mohammadfatemieh/BTS/1-commercial_airport_interactive_light-agi.jpg

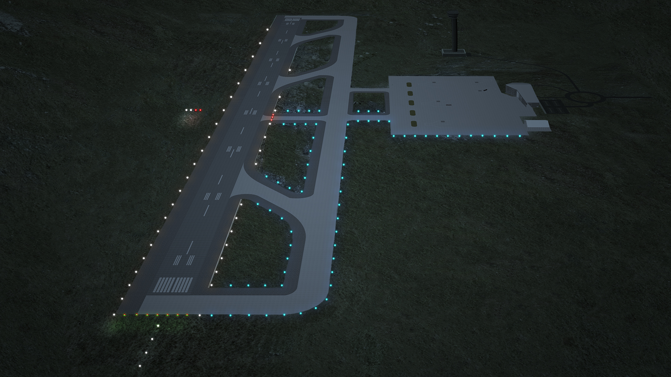
1-commercial_airport_interactive_light-agi.jpg
