mohammadfatemieh/BTS/Hardware/BTS HW v4/Air_Unit/Air_Unit_240316.PcbDoc.htm

Reporting Options

# File in Previous Format

Date | : | 4/20/2017
Time | : | 11:17:37 AM
Filename | : | C:\Users\ngoqu\Google Drive\In working\I Store medicin\Hardware\BTS HW v4\Air_Unit\Air_Unit_240316.PcbDoc

Version | Warning

This file was generated by an earlier version of the software
