mohammadfatemieh/BTS/Visio-Tongquanhethong.pdf

# 14 OMC

# External Sensor

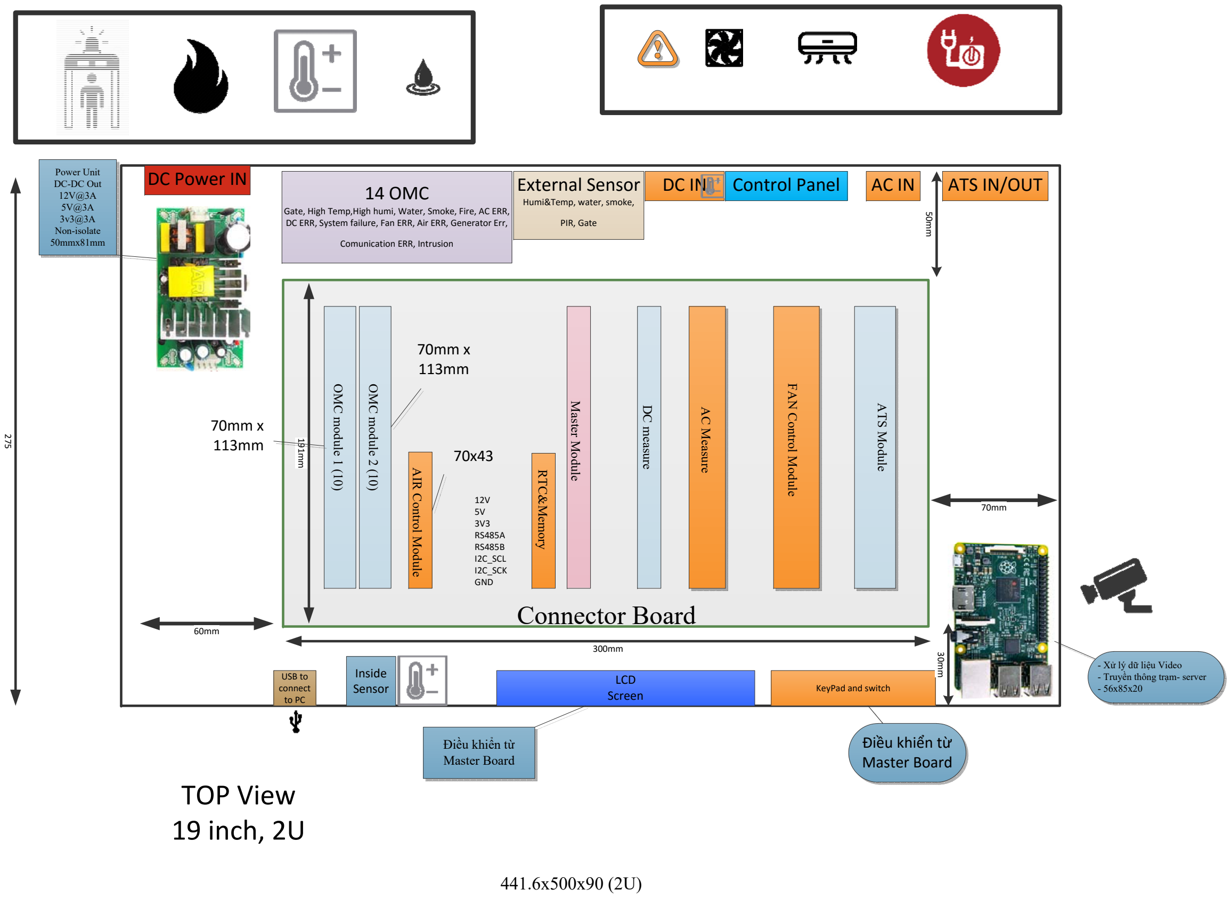
[picture p4: page 1]

## LCD

Screen | KeyPad and switch

USB to
connect
to PC

## Inside Sensor

## OMC module 1 (10) Master Module DC measure AC Measure

## ATS Module

## FAN Control Module

## AIR Control Module

Gate, High Temp,High humi, Water, Smoke, Fire, AC ERR, DC ERR, System failure, Fan ERR, Air ERR, Generator Err,

Comunication ERR, Intrusion

Humi&Temp, water, smoke,

PIR, Gate

# DC Power IN

## RTC&Memory

DC IN | Control Panel | AC IN | ATS IN/OUT

# TOP View 19 inch, 2U

# Connector Board

# 441.6x500x90 (2U)

60mm

70mm

275

300mm

191mm

30mm

50mm

12V
5V
3V3
RS485A
RS485B
I2C_SCL
I2C_SCK
GND

## OMC module 2 (10)

- Xử lý dữ liệu Video
- Truyền thông trạm- server
- 56x85x20

Power Unit
DC-DC Out
12V@3A
5V@3A
3v3@3A
Non-isolate
50mmx81mm

## Điều khiển từ Master Board

## Điều khiển từ Master Board

## 70mm x

113mm | 70x43 70mm x
| 113mm
