mohammadfatemieh/BTS/Tongquanhethong.png

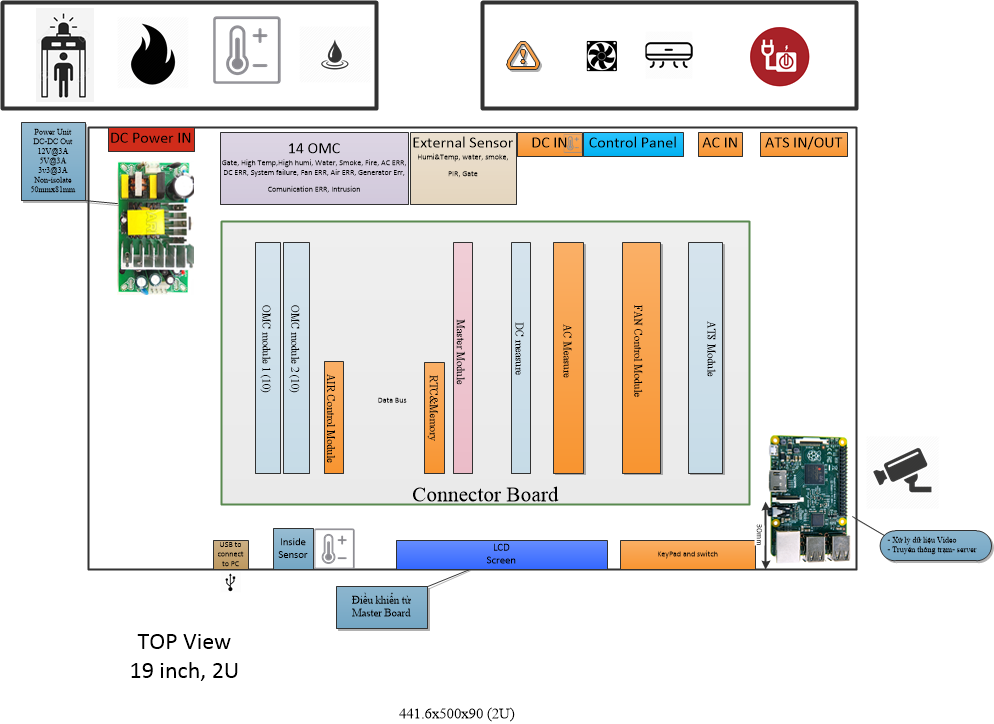
Tongquanhethong.png
