mohammadfatemieh/BTS/Hardware/IStoreMedicinv1.xlsx

Comment | Description | Designator | Footprint | Quantity | Price | Total
Thạch anh | 25MHz | 1 | cry | 2 | 2000 | 4000
Tụ điện 0603 |  |  |  | 200 | 500 | 100000
Còi hú, đèn |  |  |  | 1 | 100000 | 100000
Relay | 220V/5A |  |  | 10 | 30000 | 300000
Transistor |  |  |  | 50 | 2000 | 100000
LCD | 182x64 |  |  | 1 | 250000 | 250000
LED_RED_0805 | Typical INFRARED GaAs LED | D1 | LED 0805 TOP | 20 | 800 | 16000
Cảm biến nhiệt độ, độ ẩm | Typical INFRARED GaAs LED | D2 | LED 0805 TOP | 1 | 500000 | 500000
LED_GREEN_0805 | Typical INFRARED GaAs LED | D3 | LED 0805 TOP | 1 | 800 | 800
RJ45 | RJ45 Connector, with Leds | J1 | CONNECTOR_RJ45_HR911102A | 5 | 25000 | 125000
Điện trở 0805 | Resistor |  | RES_0805_TOP | 200 | 100 | 20000
RơLe | RALAY SOLID SSR-40DD FOTEK |  |  | 2 | 95000 | 190000
Cảm biến khói/Cháy | MQ8 |  |  | 1 | 110000 | 110000
LM35 | Cảm biến nhiệt độ |  |  | 2 | 20000 | 40000
Công tắc từ |  |  |  | 1 | 50000 | 50000
Cảm biến dòng | 20A/100mA/250KHz |  |  | 4 | 55000 | 220000
LM358 | Khuếch đại thuật toán |  |  | 10 | 7000 | 70000
BUTTON 2P | Switch | S1 | Nut nhan 2 chan dung | 5 | 4000 | 20000
STM32F107 | STM32 ARM-based 32-bit MCU with 128 Kbytes Flash, 64-pin LQFP, Industrial Temperature | U1 | LQFP64_N | 2 | 80000 | 160000
DP83848CVV | PHY IC | U2 | LQFP48 | 1 | 70000 | 70000
Nguồn AC-DC | 220V-24V-5A |  |  | 1 | 300000 | 300000
Nguồn DC-DC | 24V-12V-5V-3V3-1A |  |  | 1 | 150000 | 150000
Nguồn DC-DC | 48V-24V-5A |  |  | 1 | 250000 | 250000
Cầu chì | 5A |  |  | 3 | 10000 | 30000
Mạch in |  |  |  | 1 | 1000000 | 1000000
Quạt thông gió |  |  |  | 1 | 40000 | 40000
Dây cáp/dây điện |  |  |  | 1 | 100000 | 100000
Giắm cắm/Công tắc/Nút bấm |  |  |  | 20 | 12000 | 240000
S25FL204K | Flash Memory | U3 | SOIC_8 | 1 | 25000 | 25000
 |  |  |  |  |  | 4580800
