mohammadfatemieh/BTS/Hardware/IO_Board/IO_Boardv3_RelayAlarm.pdf

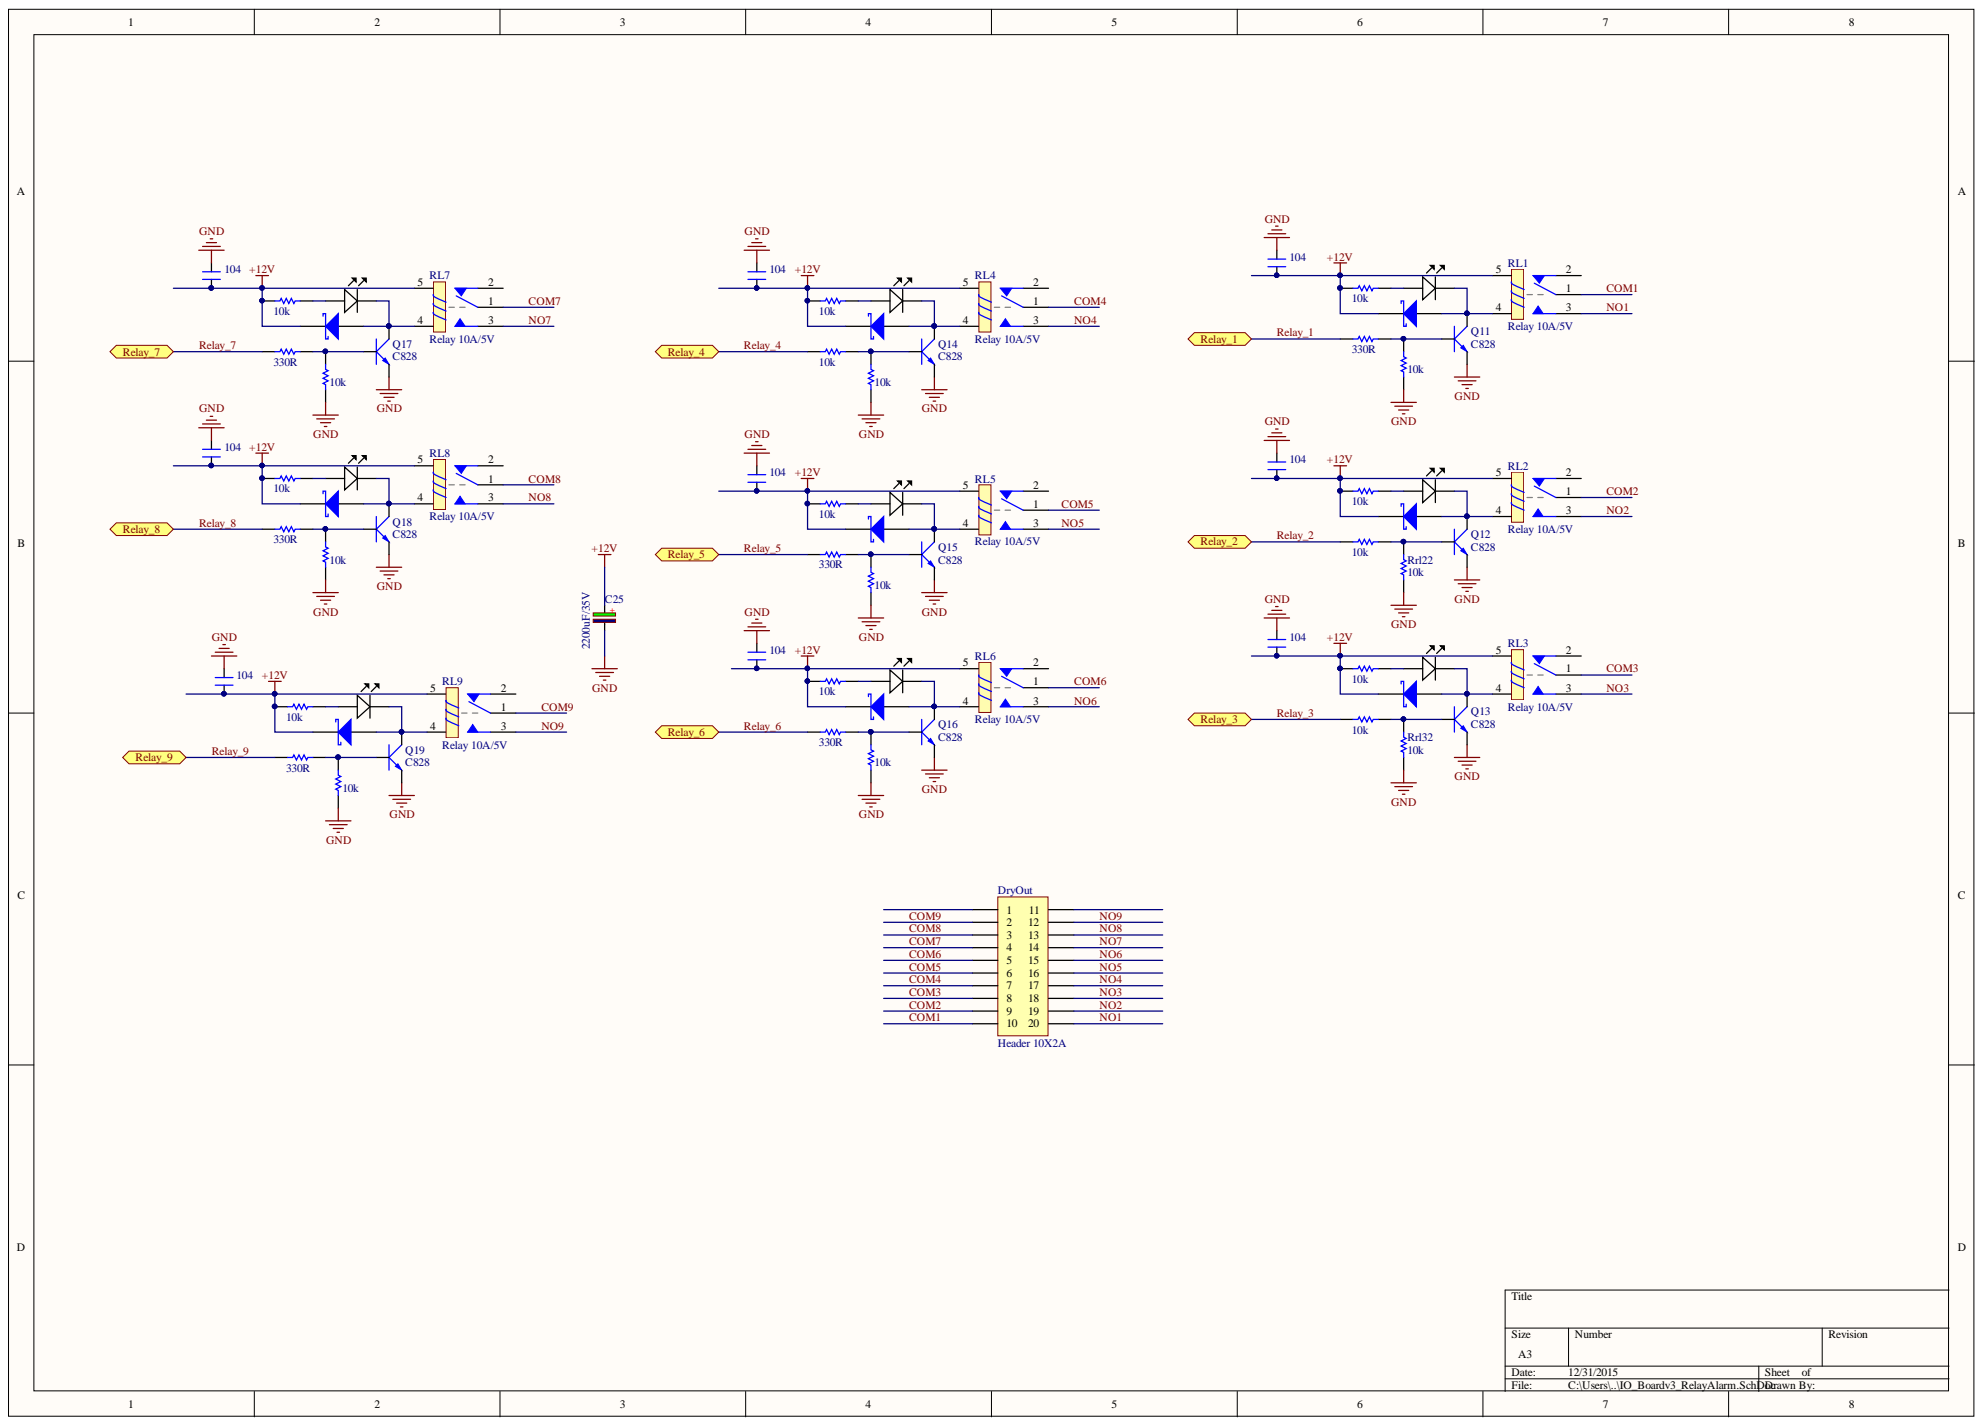
[picture p72: page 1]

# Board S
