mohammadfatemieh/BTS/Hardware/BTS HW v4/FAN Unit/FAN_Unit_250316.pdf

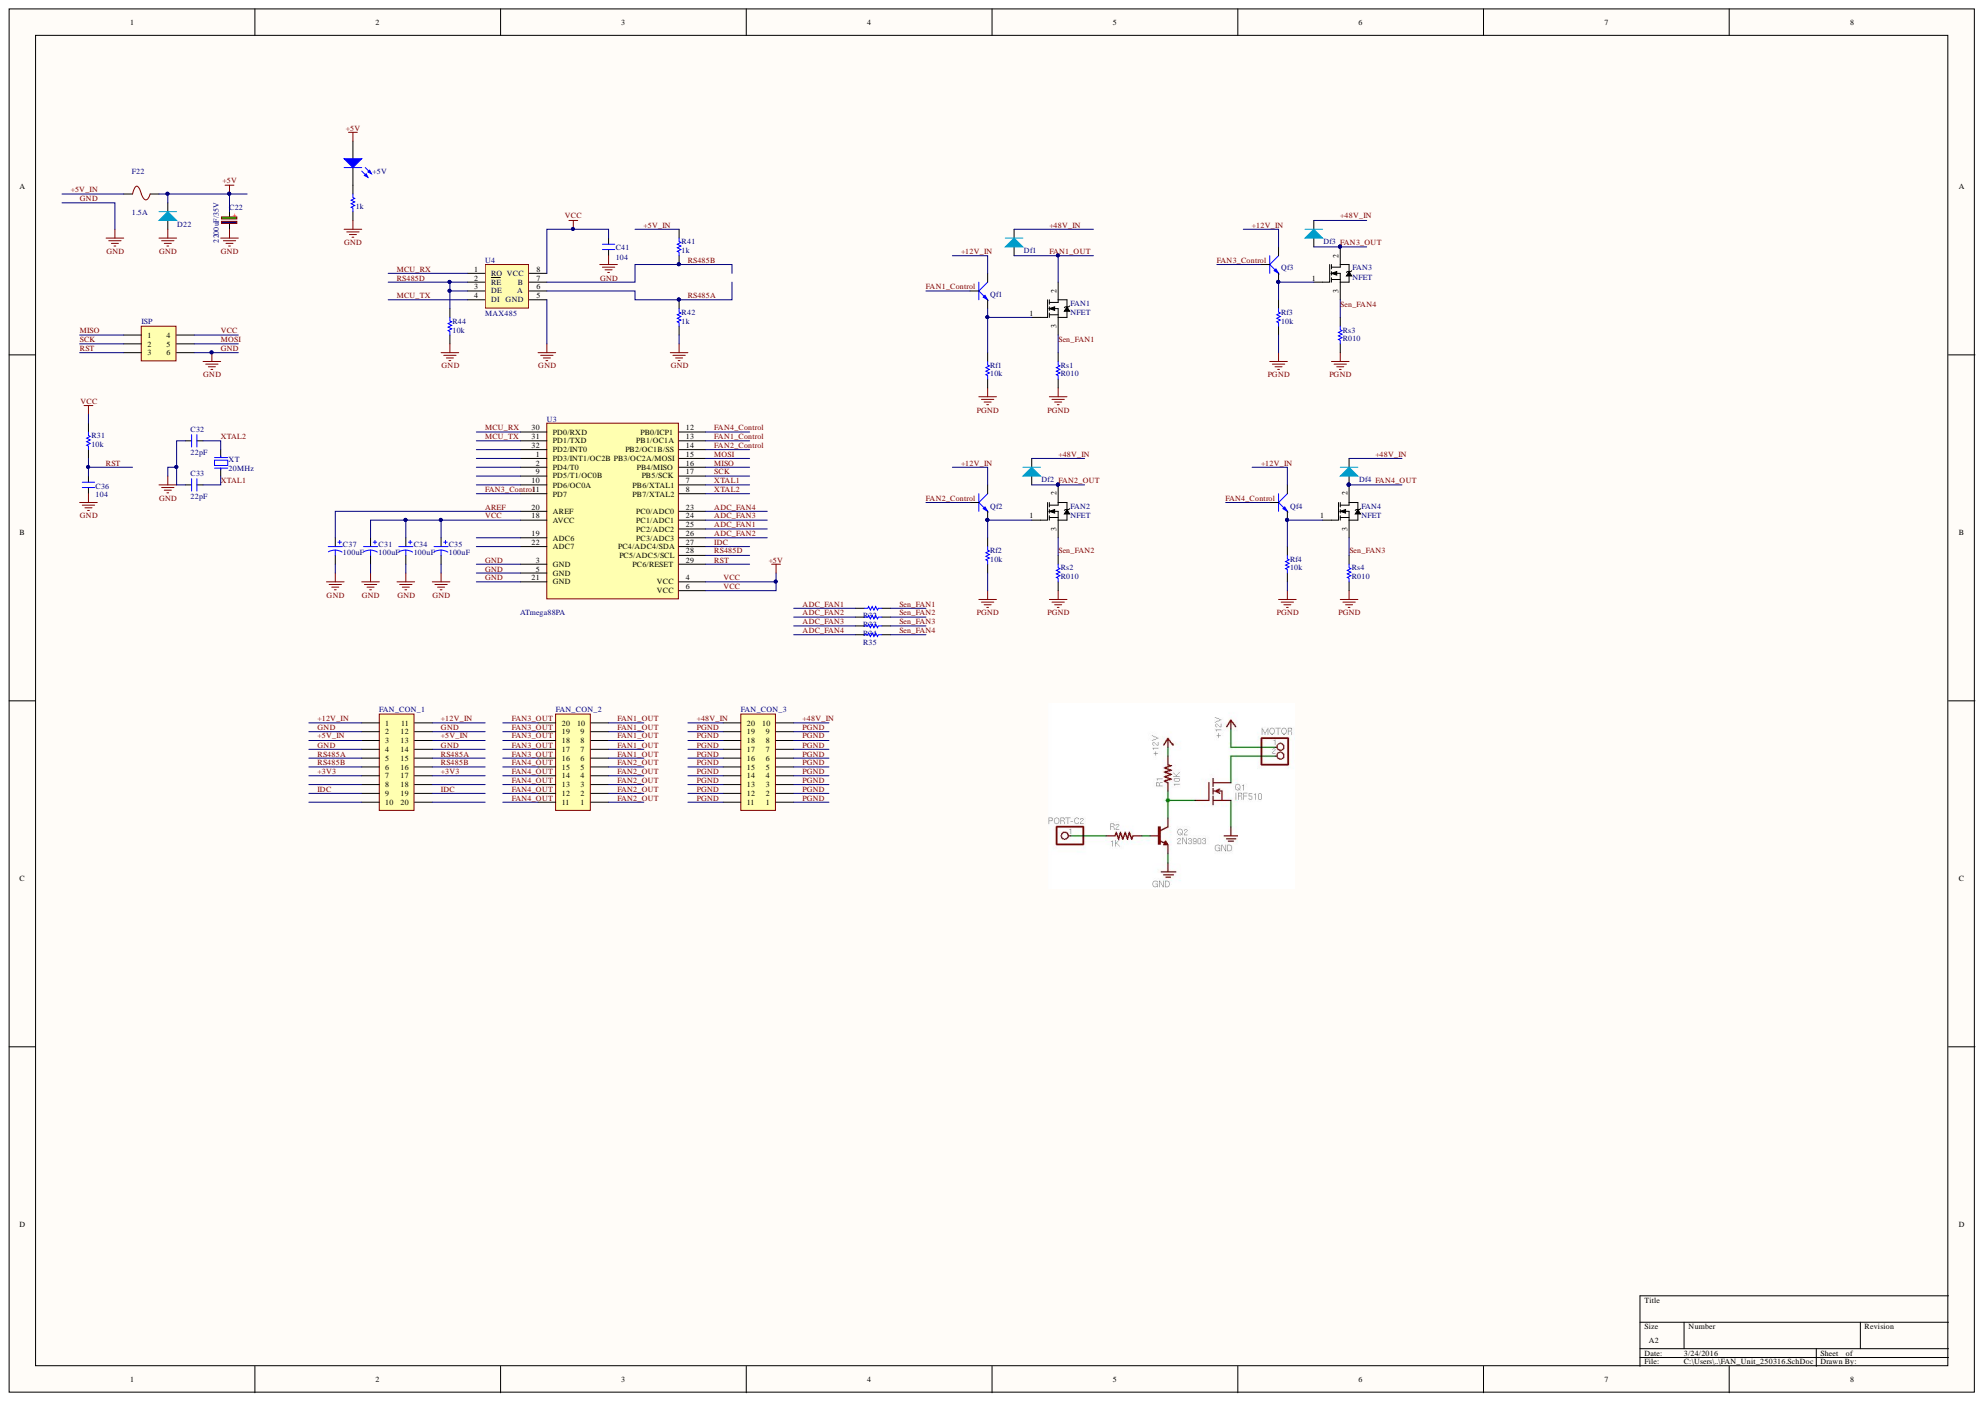
[picture p73: page 1]

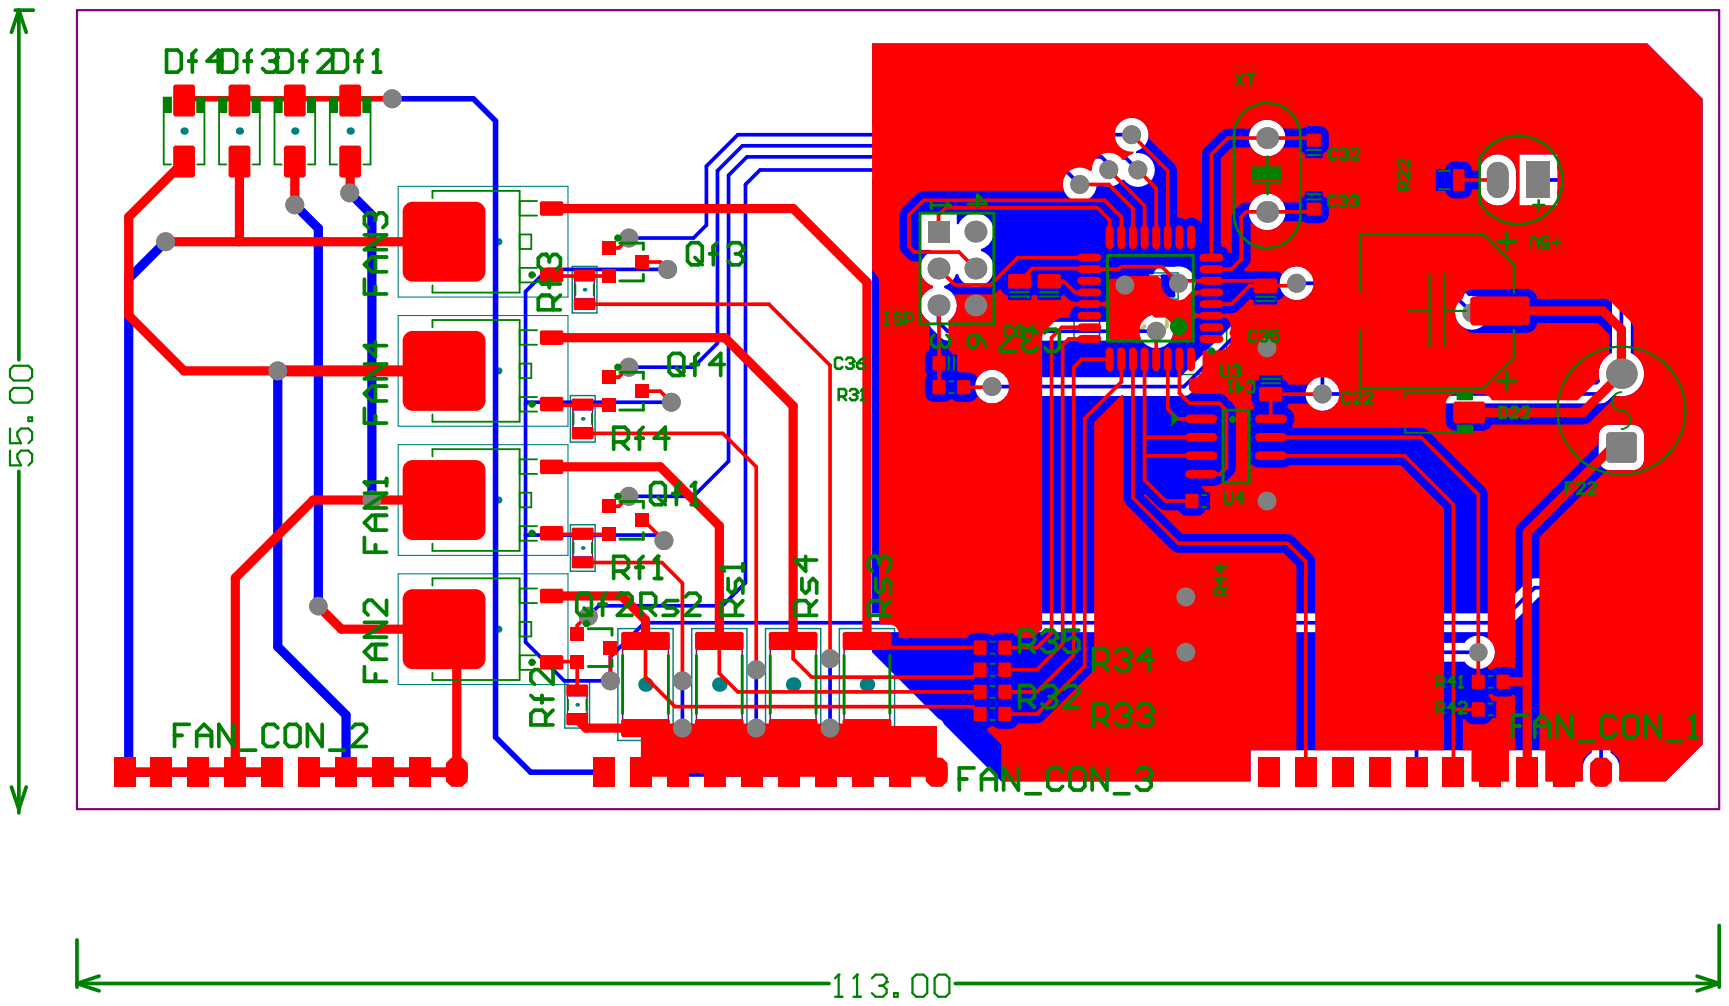
[picture p74: page 2]

# Board S
