mohammadfatemieh/BTS/Doc/amg_f4_connect_full_schematic.pdf

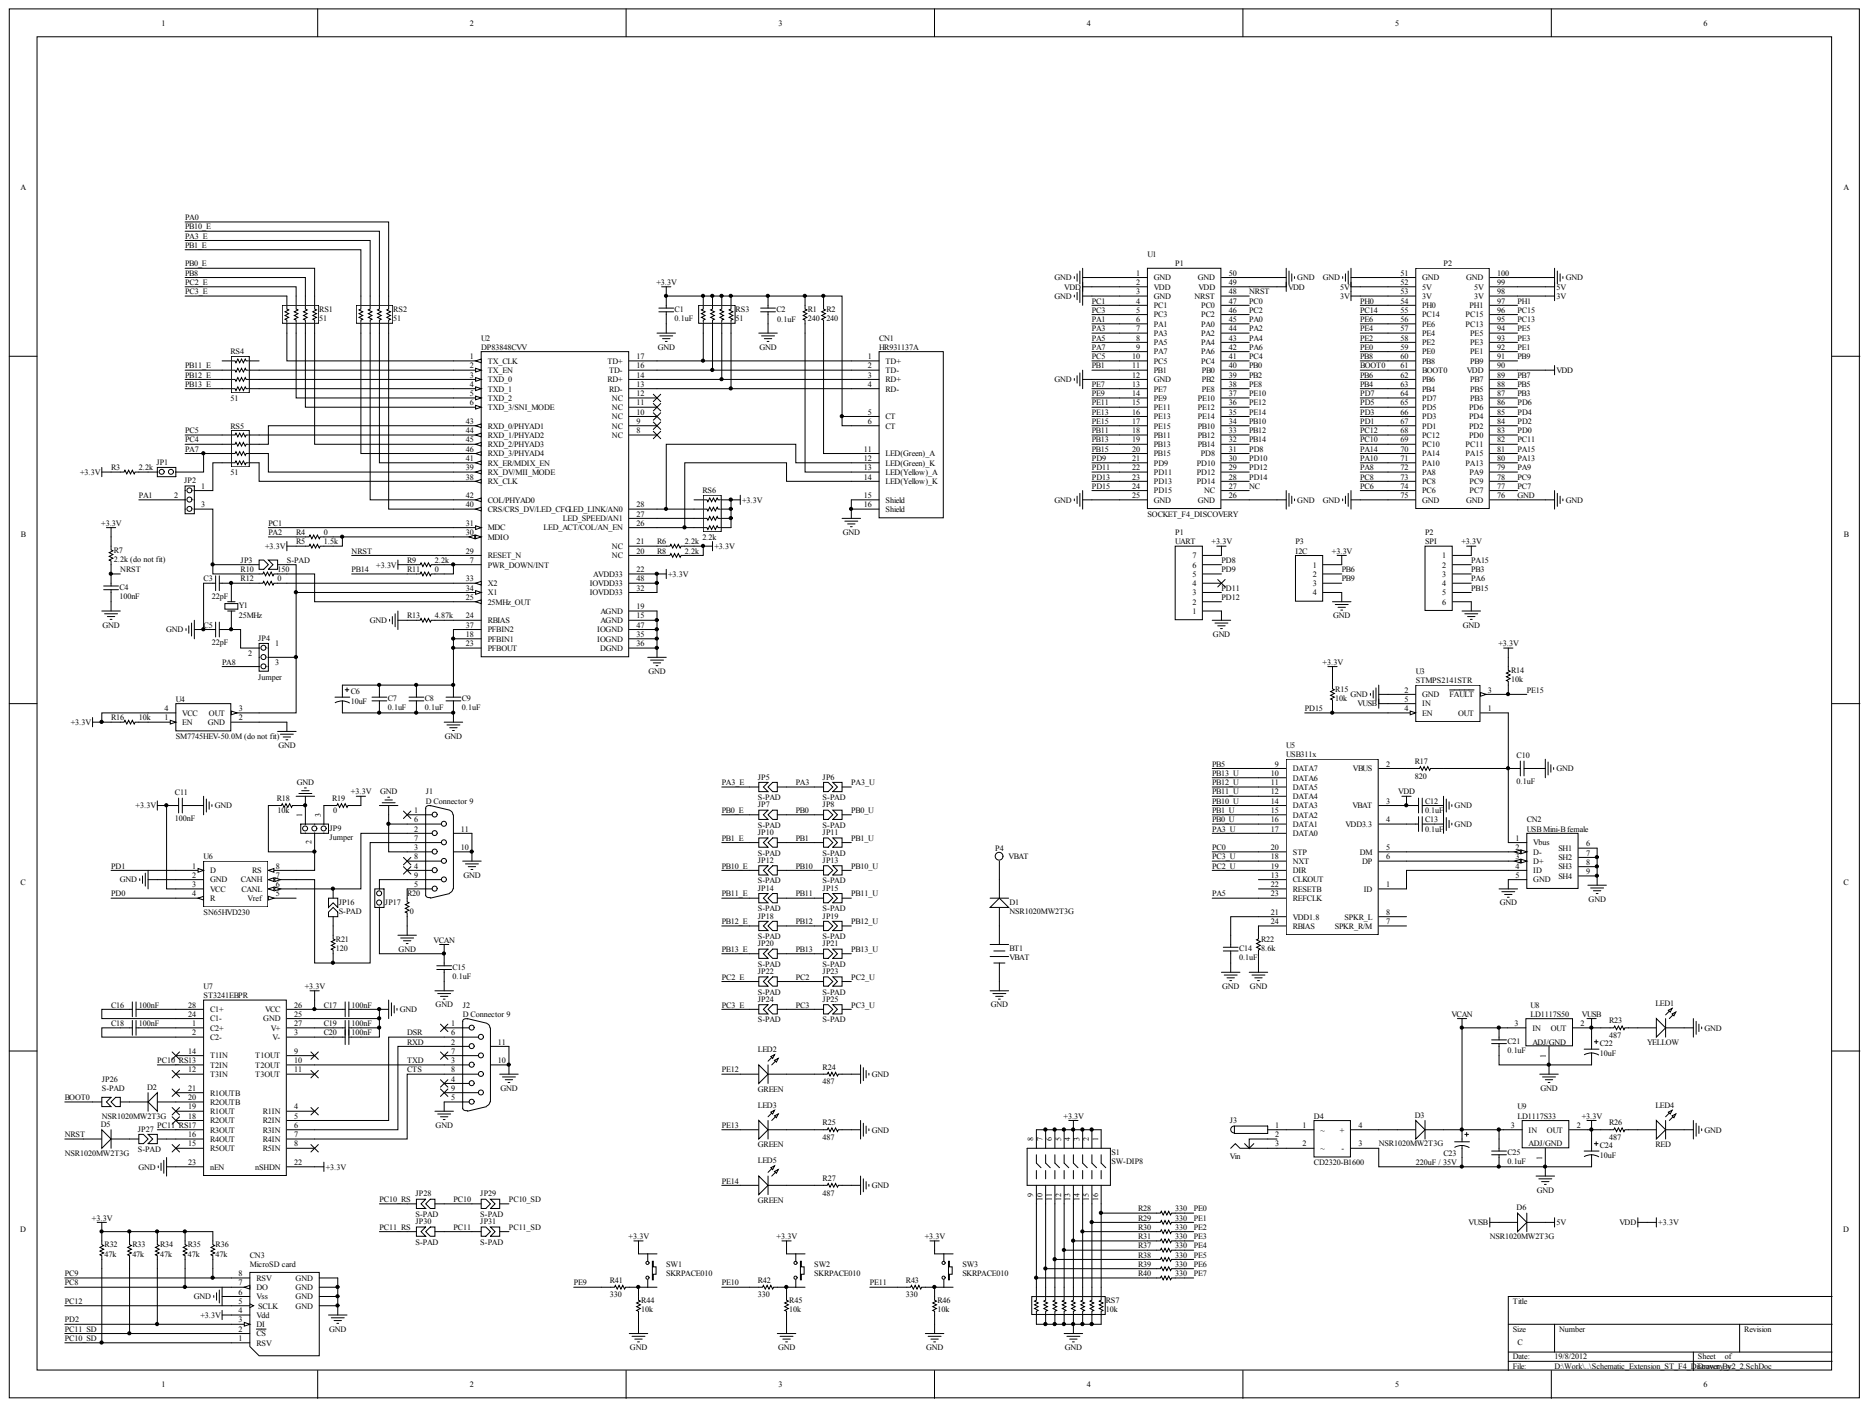
[picture p77: page 1]

RBIAS 24

PFBIN1 18
