mohammadfatemieh/BTS/Hardware/BTS HW v4/AIR_PCB.pdf

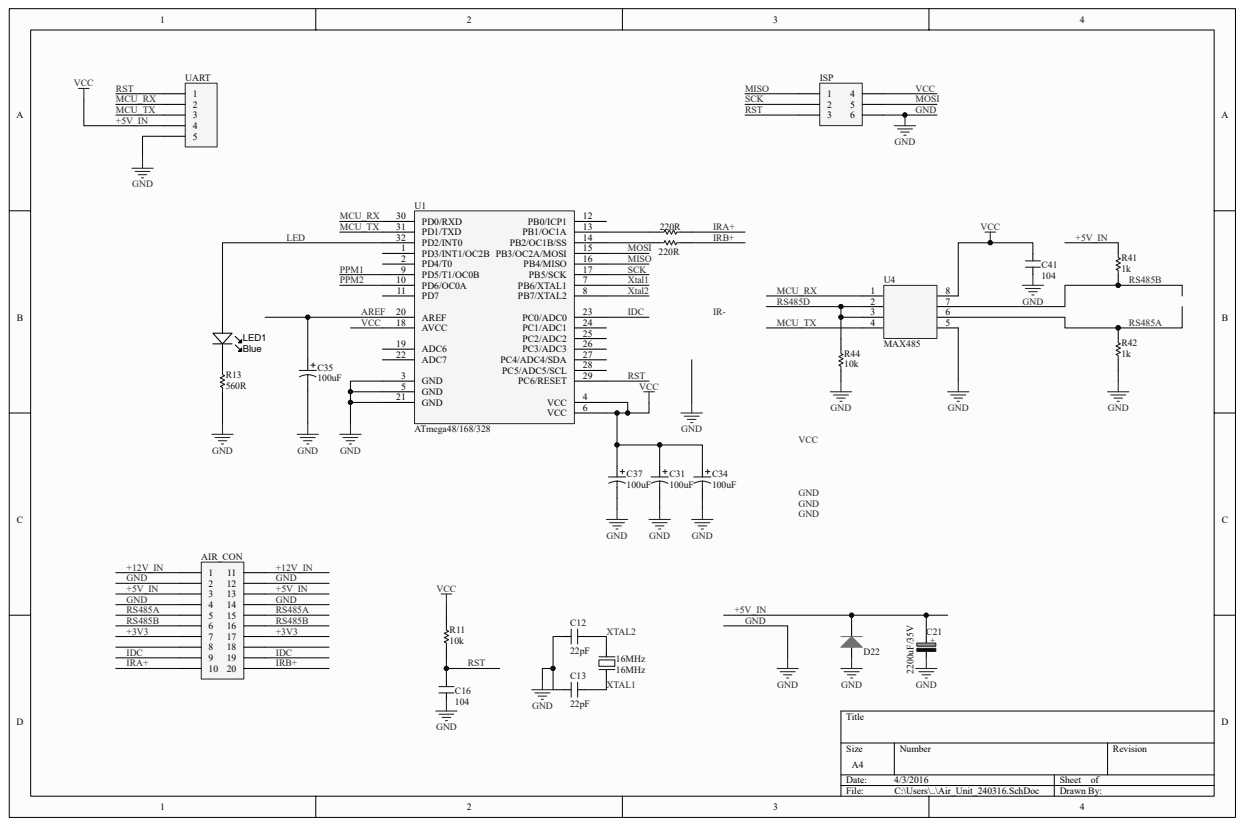
[picture p78: page 1]

Size A4 | Number | Revision

Date: 4/3/2016 | Sheet of
File: C:\Users\..\Air_Unit_240316.SchDoc | Drawn By:
