mohammadfatemieh/BTS/Hardware/BTS HW v4/AIR_SCH.pdf

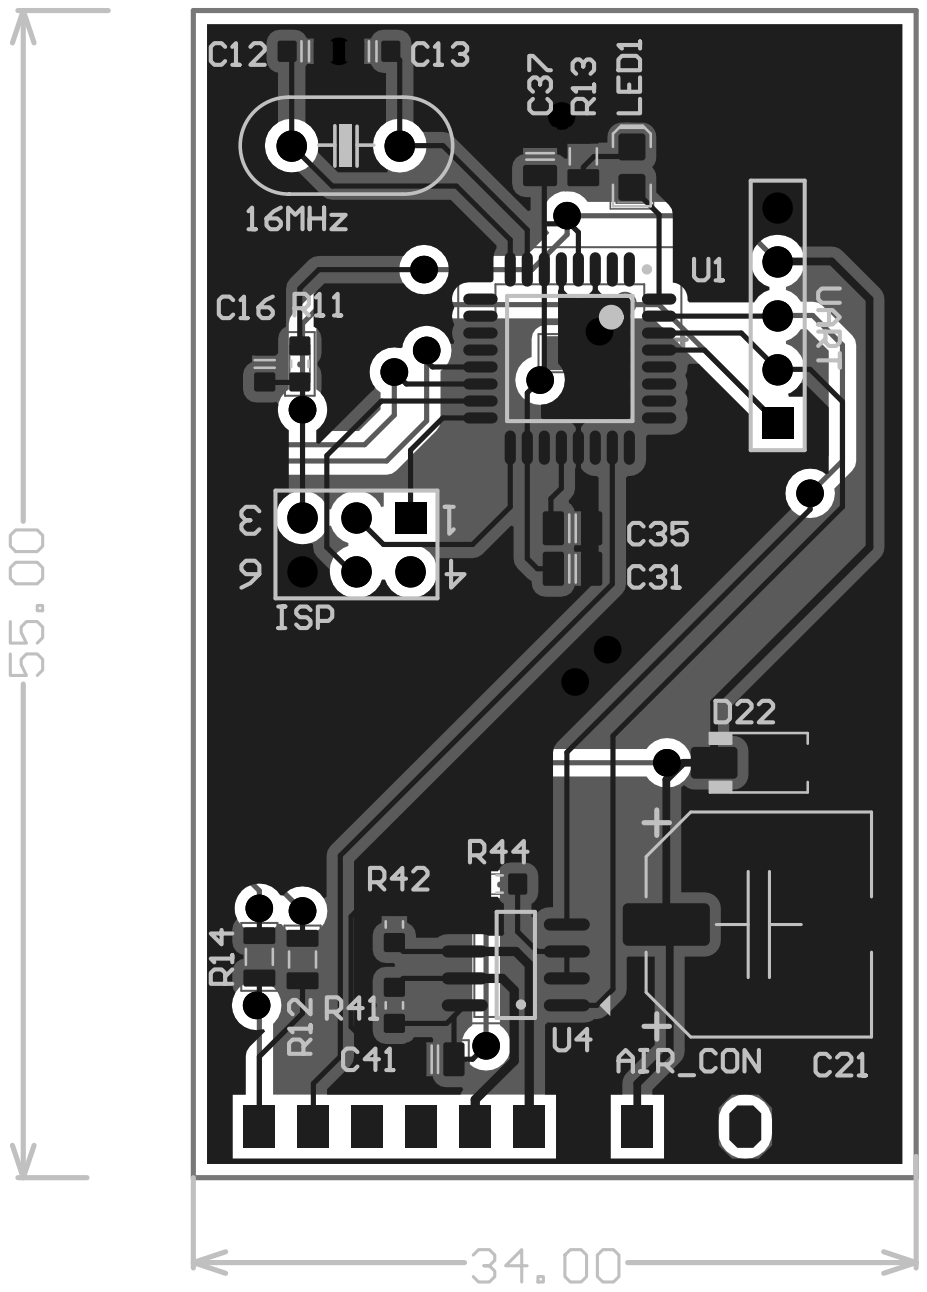
[picture p79: page 1]
