mohammadfatemieh/BTS/Hardware/BTS HW v4/ATS_PCB.pdf

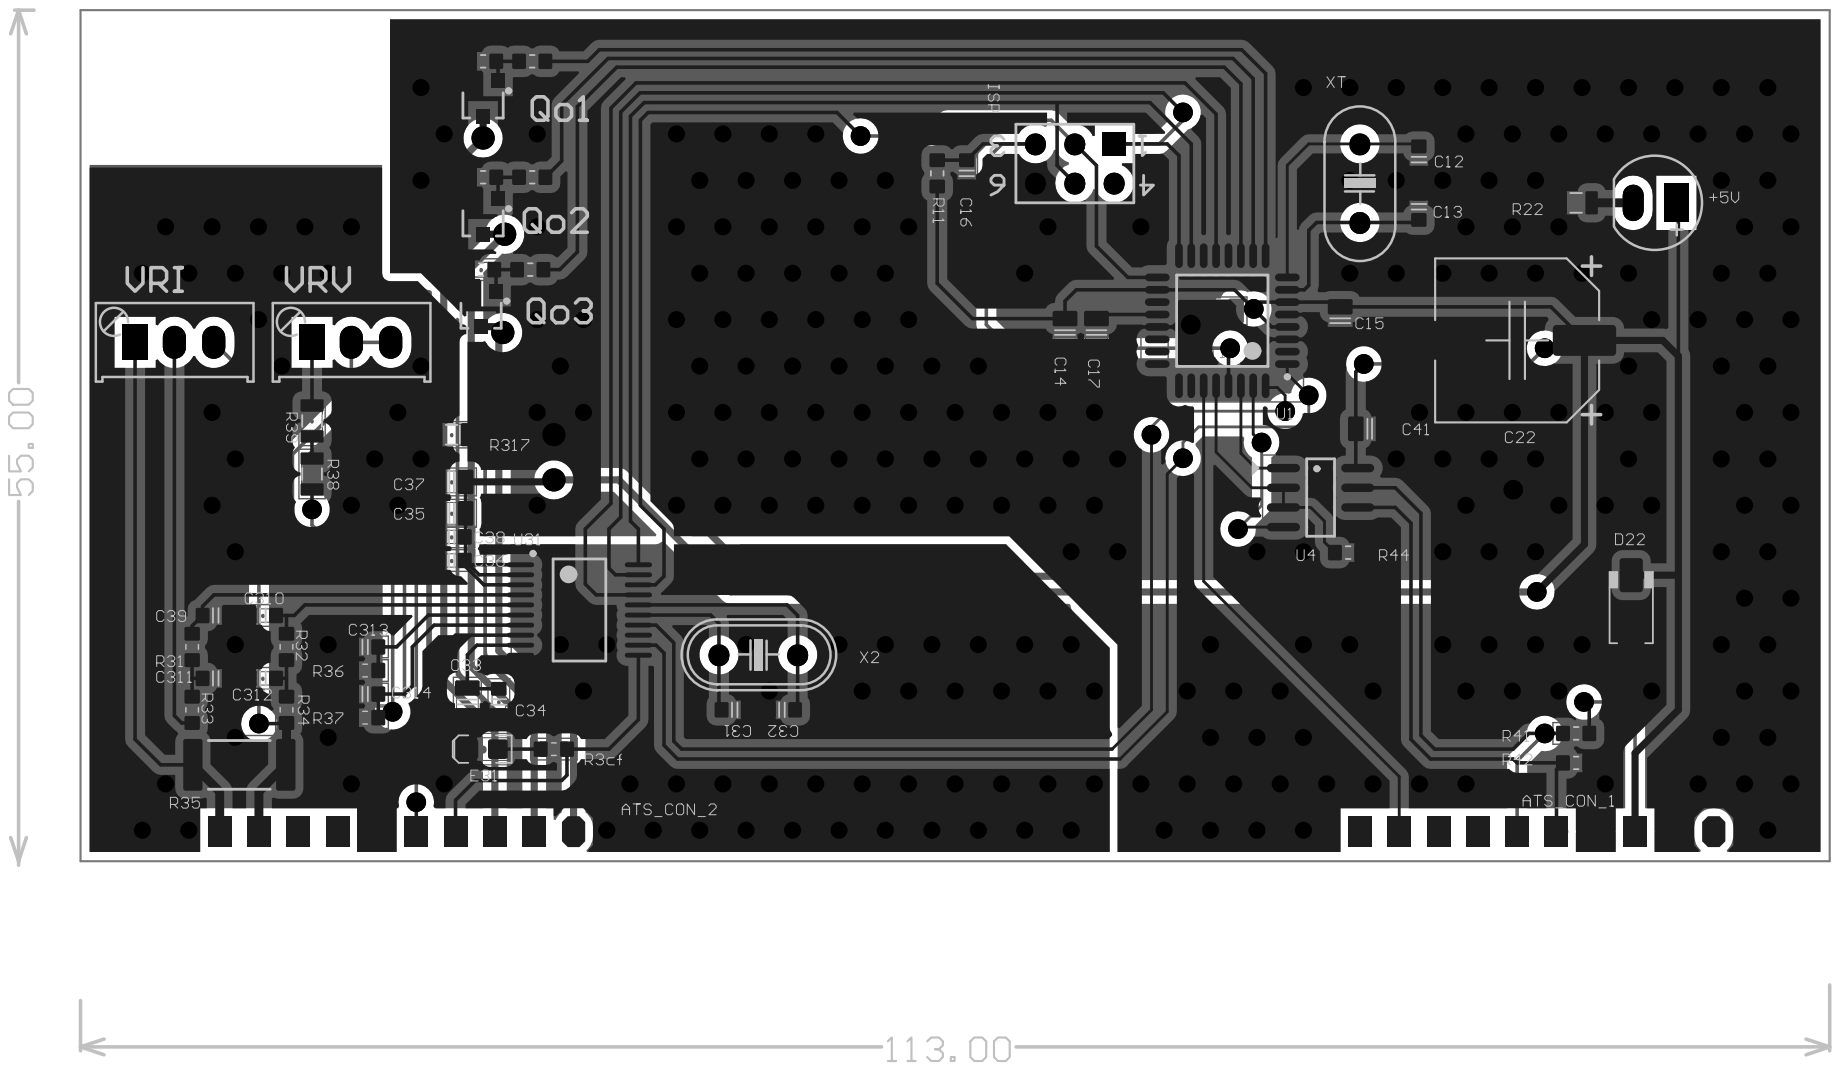
[picture p80: page 1]
