mohammadfatemieh/BTS/Hardware/BTS HW v4/ATS_Sch.pdf

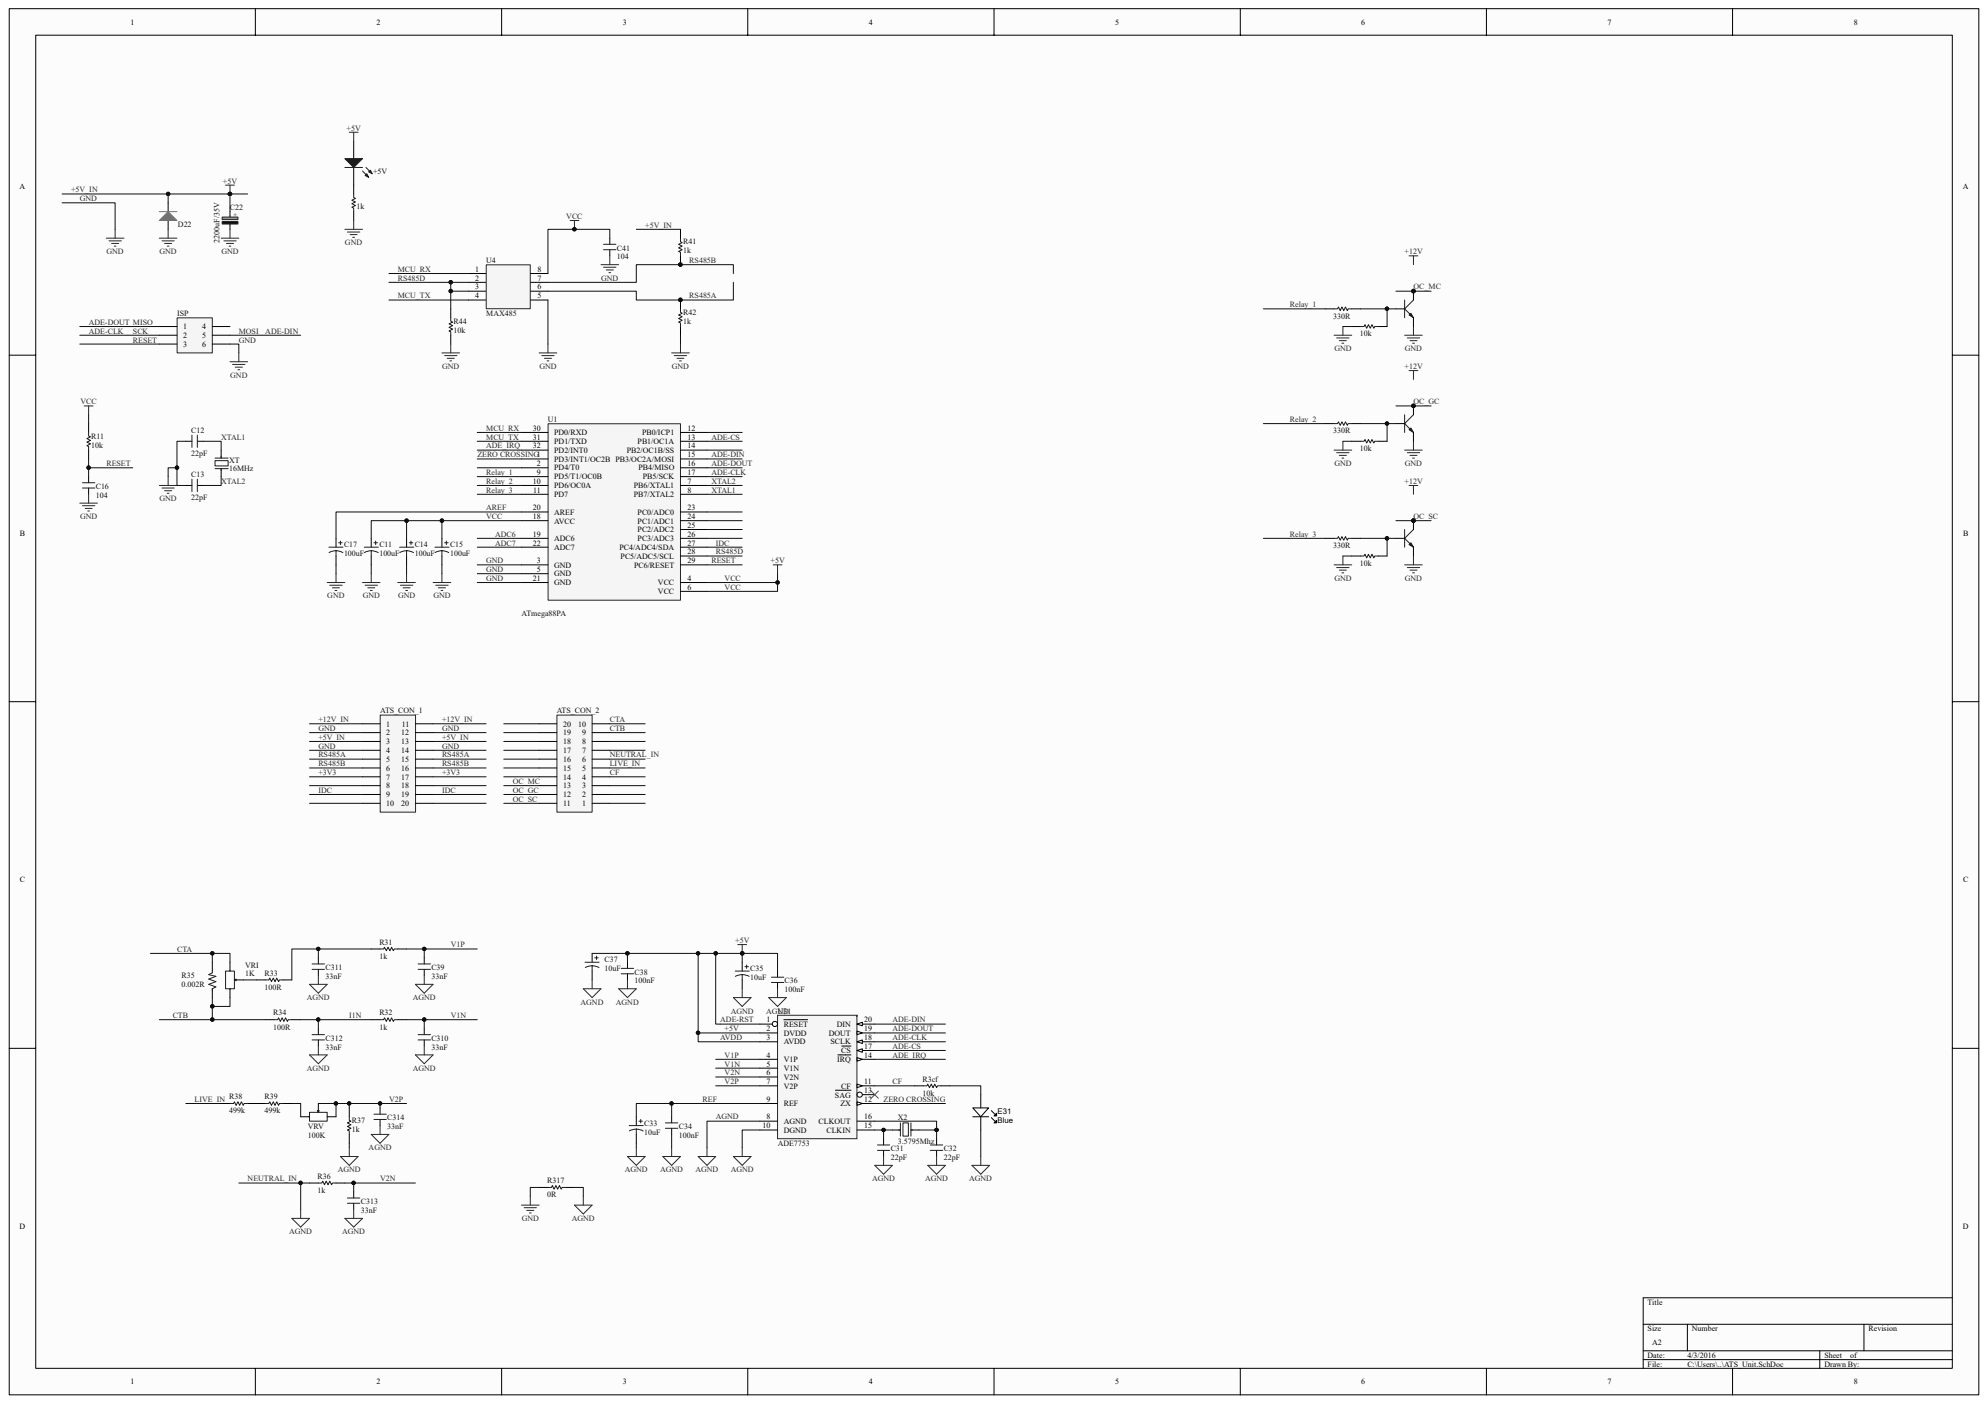
[picture p81: page 1]

Size A2 | Number | Revision

Date: 4/3/2016 | Sheet of
File: C:\Users\..\ATS_Unit.SchDoc | Drawn By:
