mohammadfatemieh/BTS/Hardware/BTS HW v4/DC_Mea_Pcb.pdf

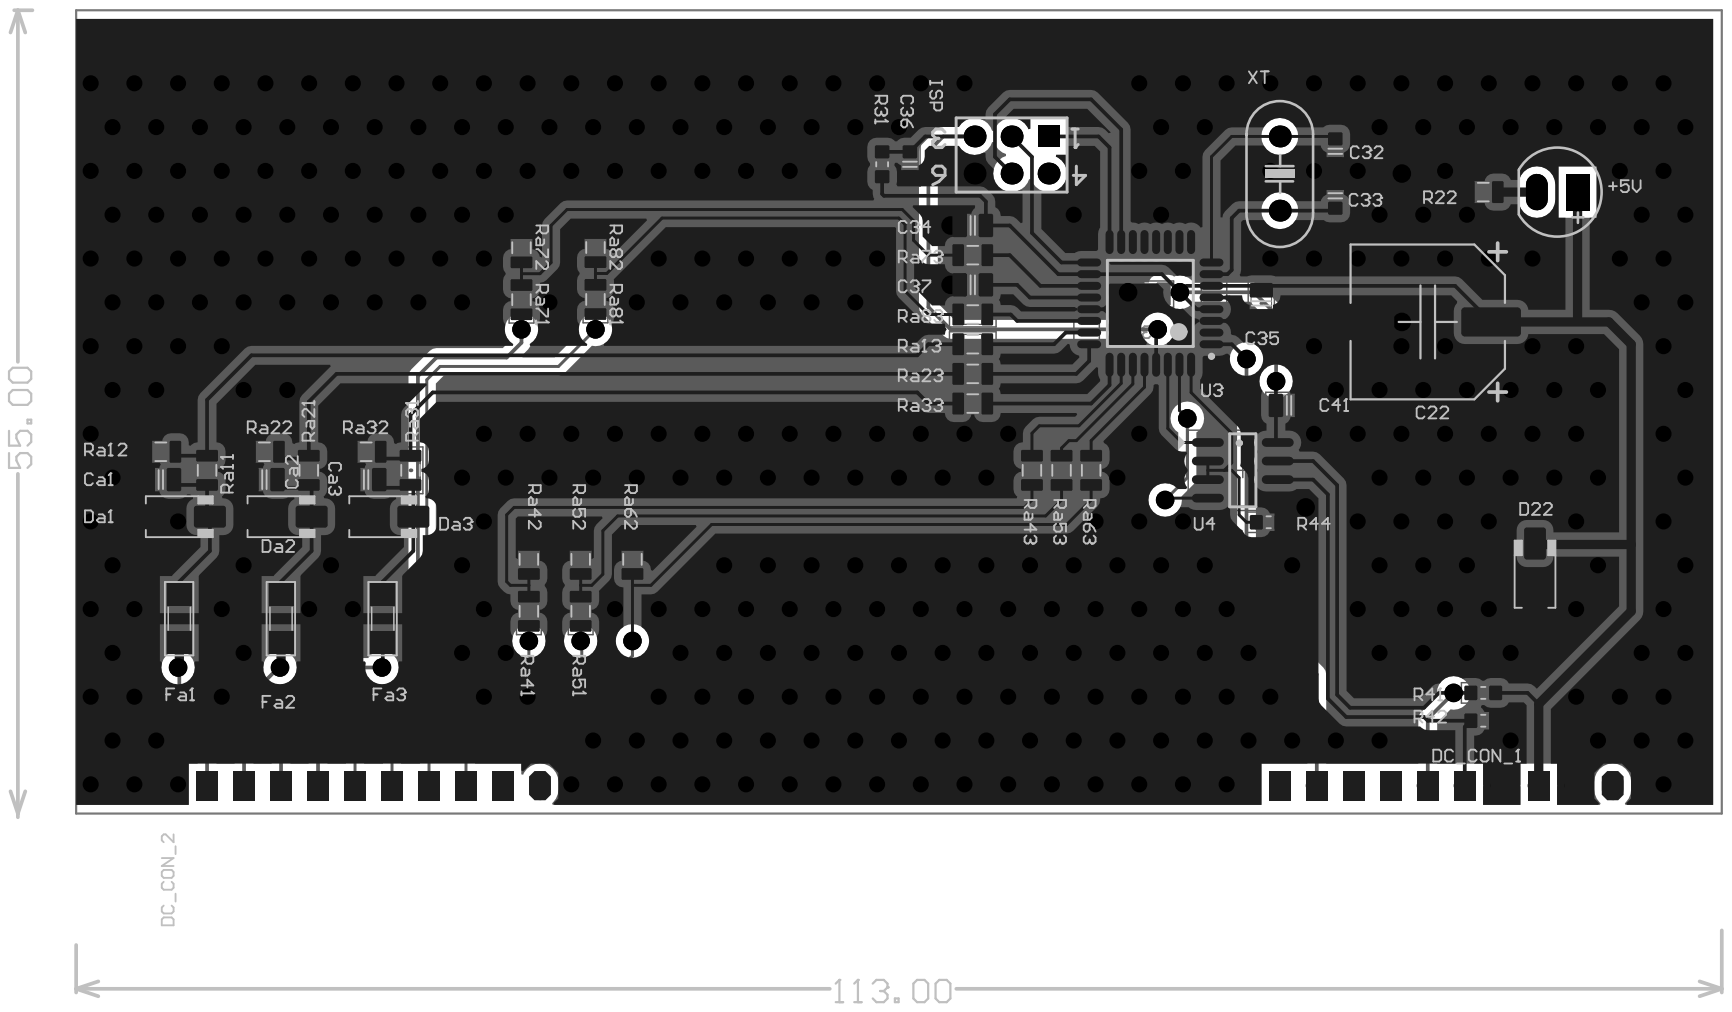
[picture p82: page 1]
