mohammadfatemieh/BTS/Hardware/BTS HW v4/DC_Mea_Sch.pdf

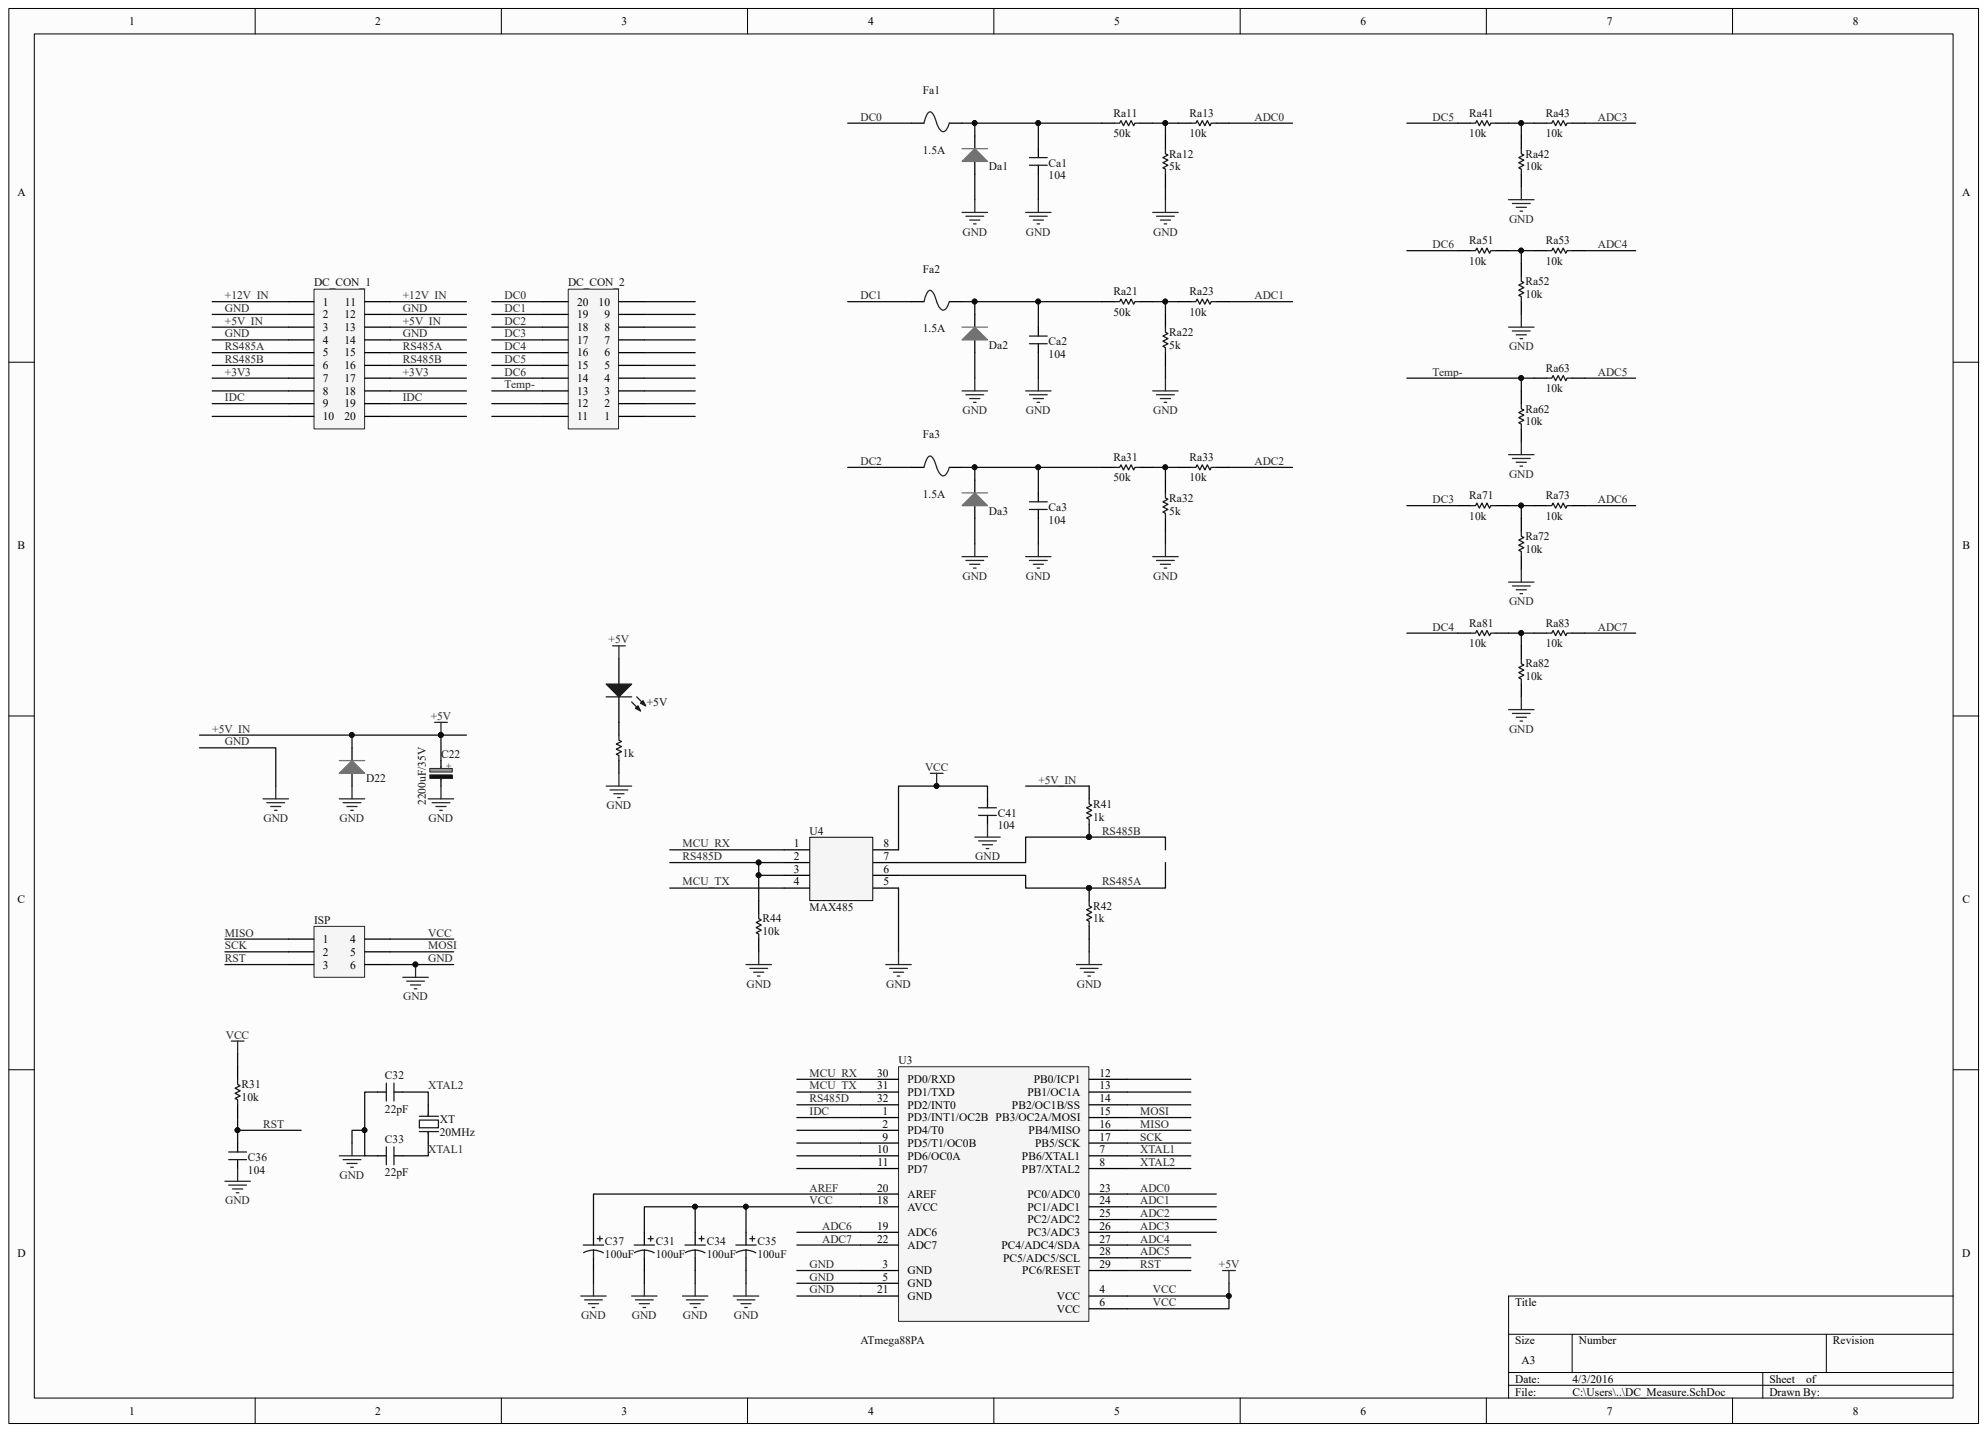
[picture p83: page 1]
