mohammadfatemieh/BTS/Hardware/BTS HW v4/FAN CHE.pdf

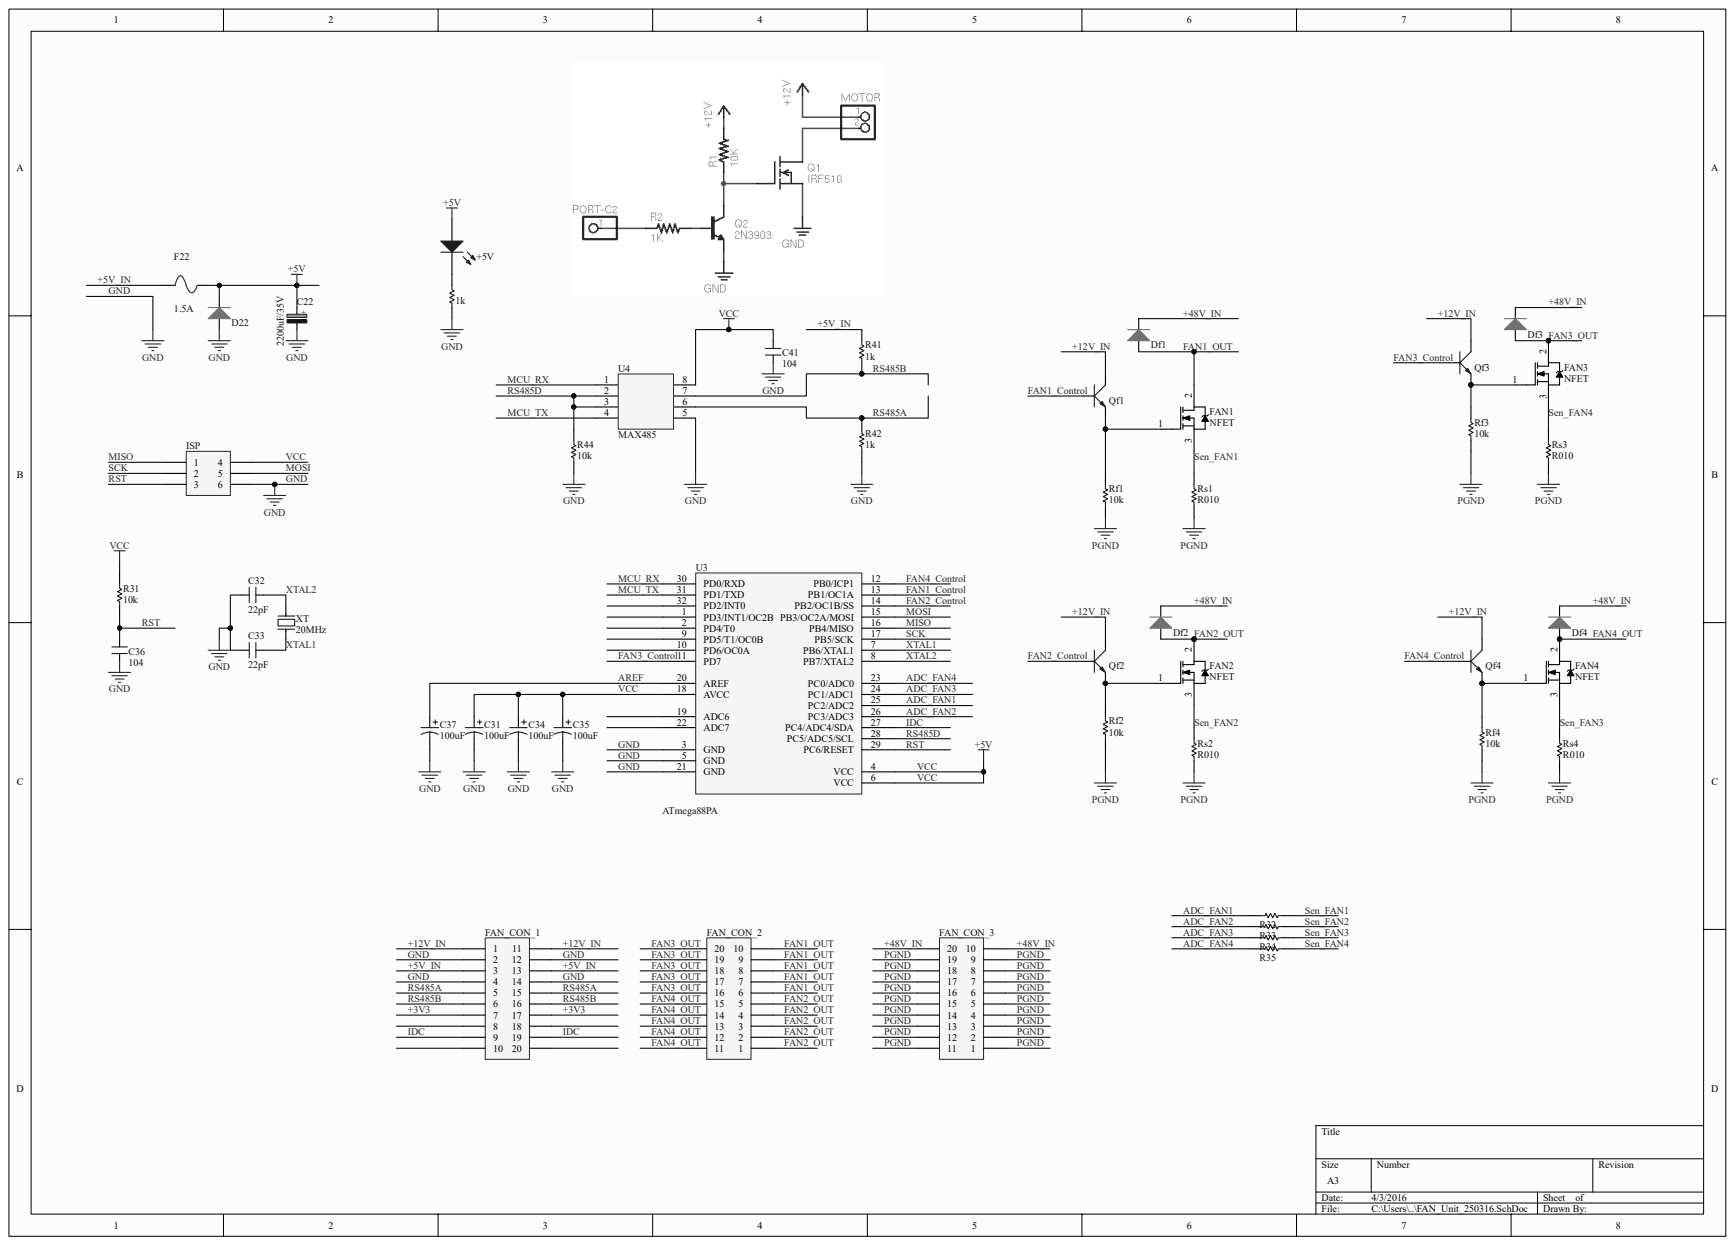
[picture p84: page 1]

Size A3 | Number | Revision

Date: 4/3/2016 | Sheet of
File: C:\Users\..\FAN_Unit_250316.SchDoc | Drawn By:
