mohammadfatemieh/BTS/Hardware/BTS HW v4/FAN PCB.pdf

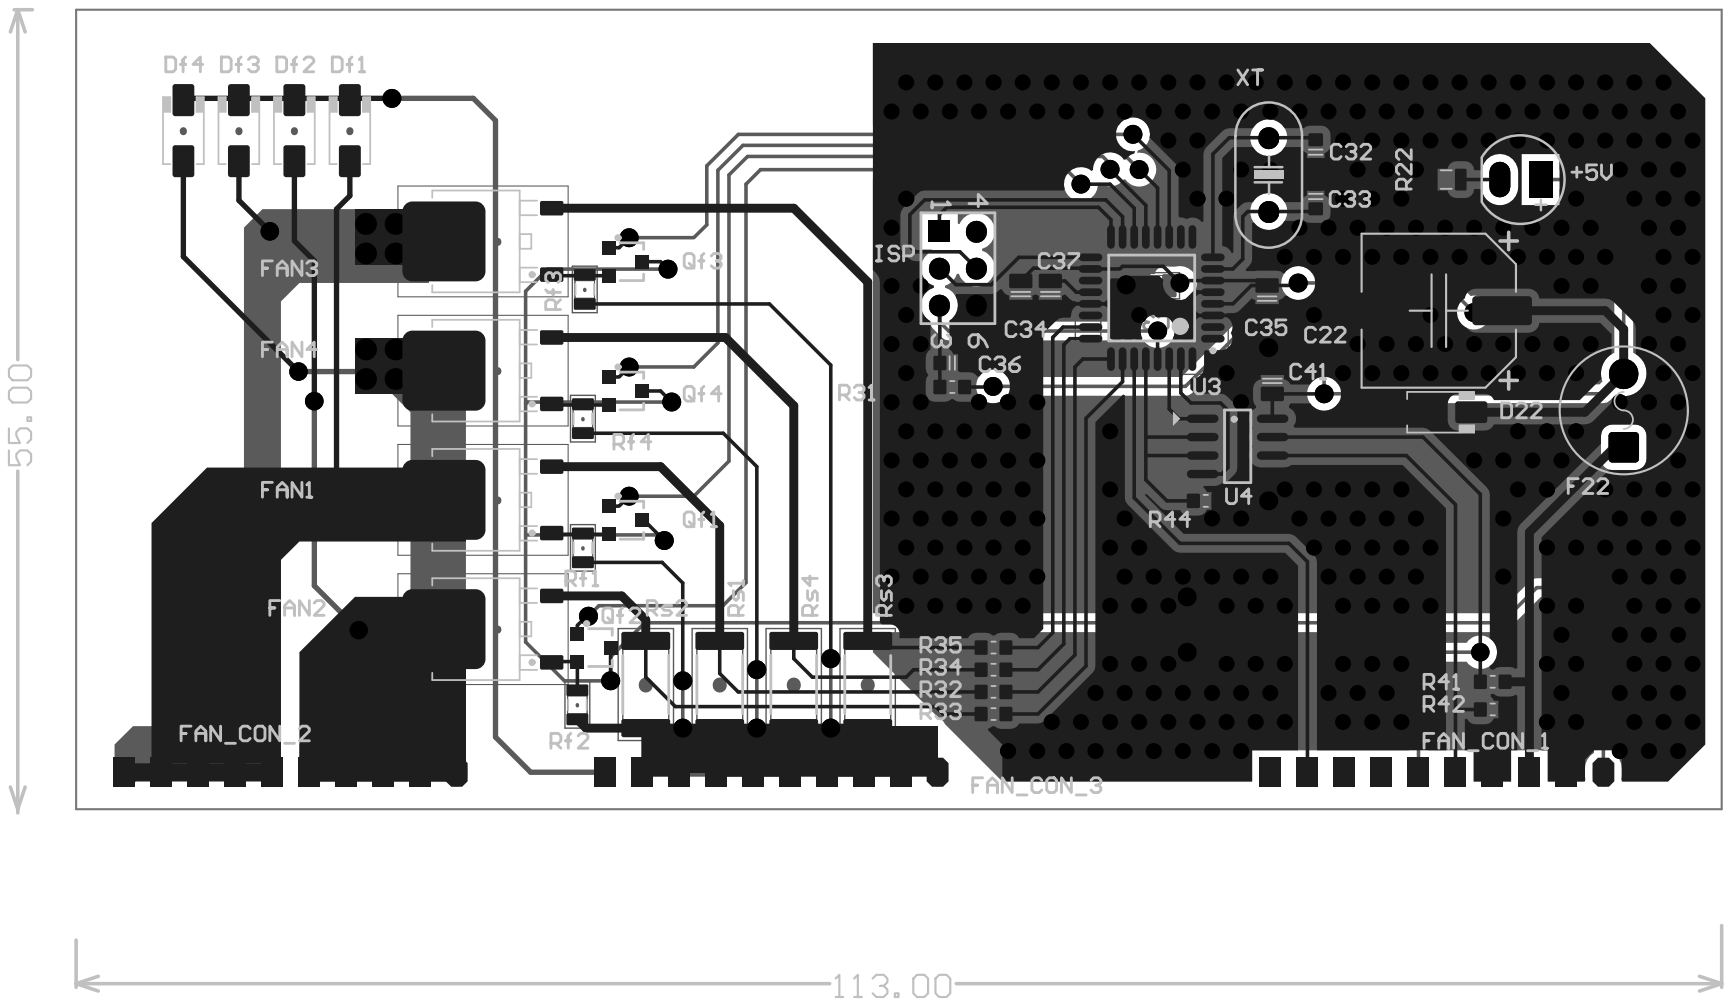
[picture p85: page 1]
