mohammadfatemieh/BTS/Hardware/BTS HW v4/OMC PCB.pdf

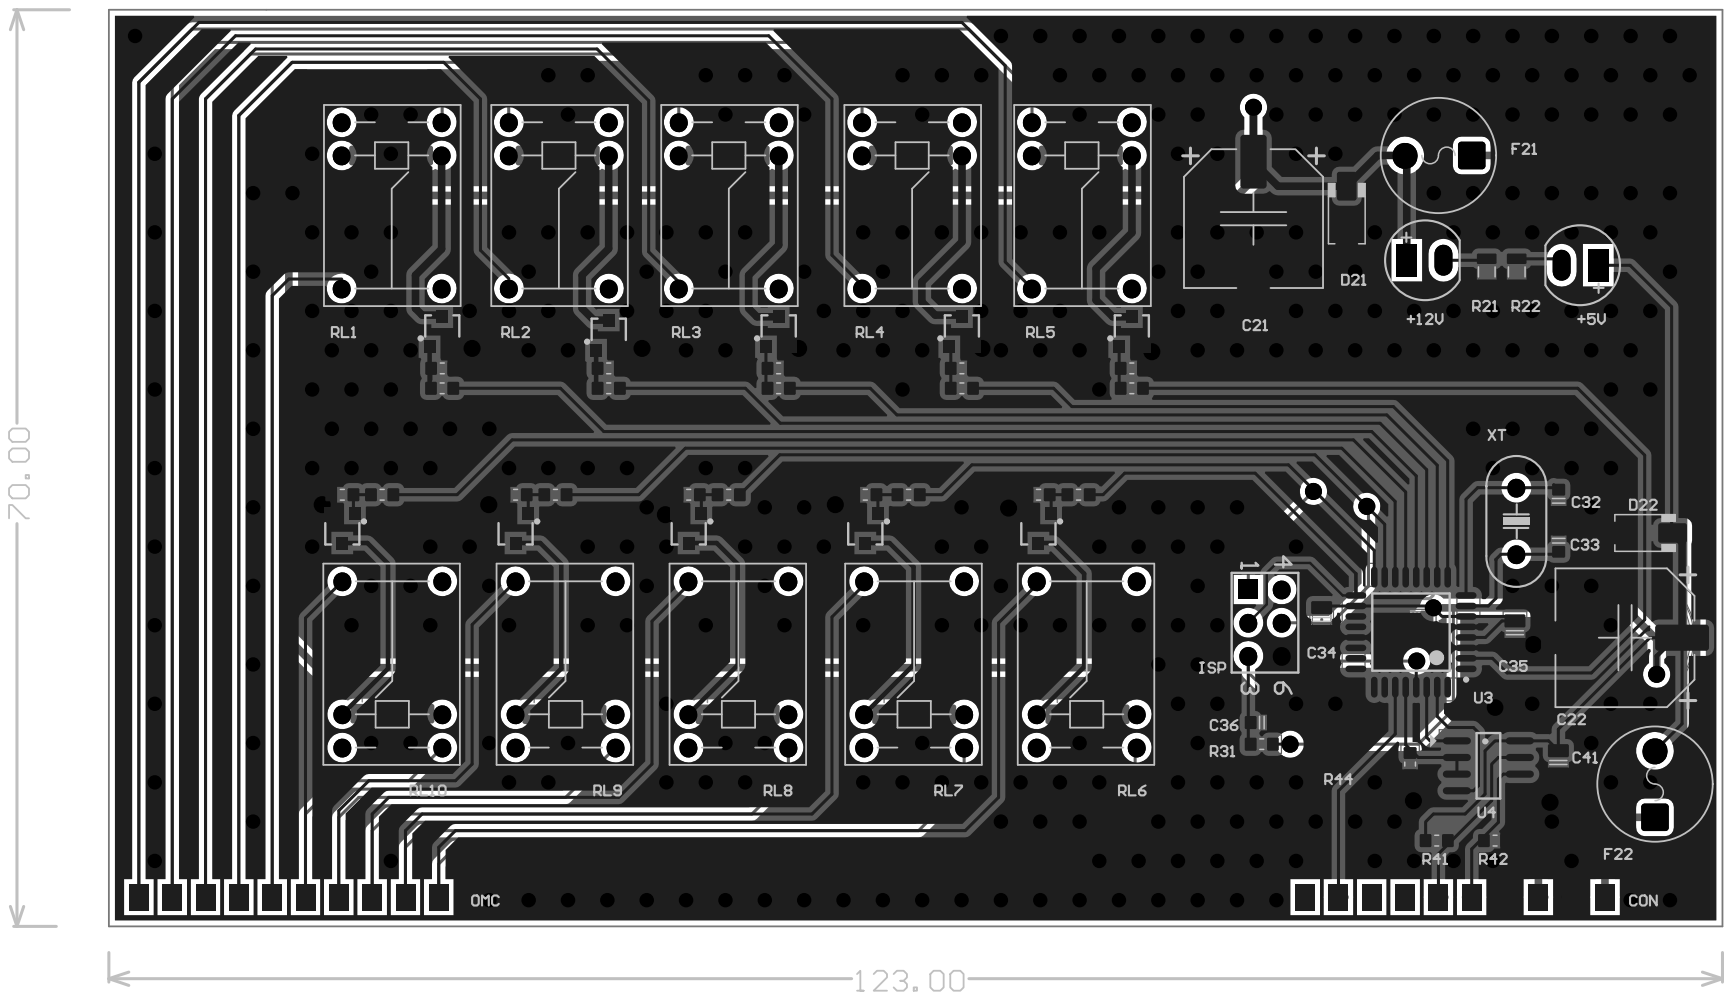
[picture p86: page 1]
