mohammadfatemieh/BTS/Hardware/BTS HW v4/OMC.pdf

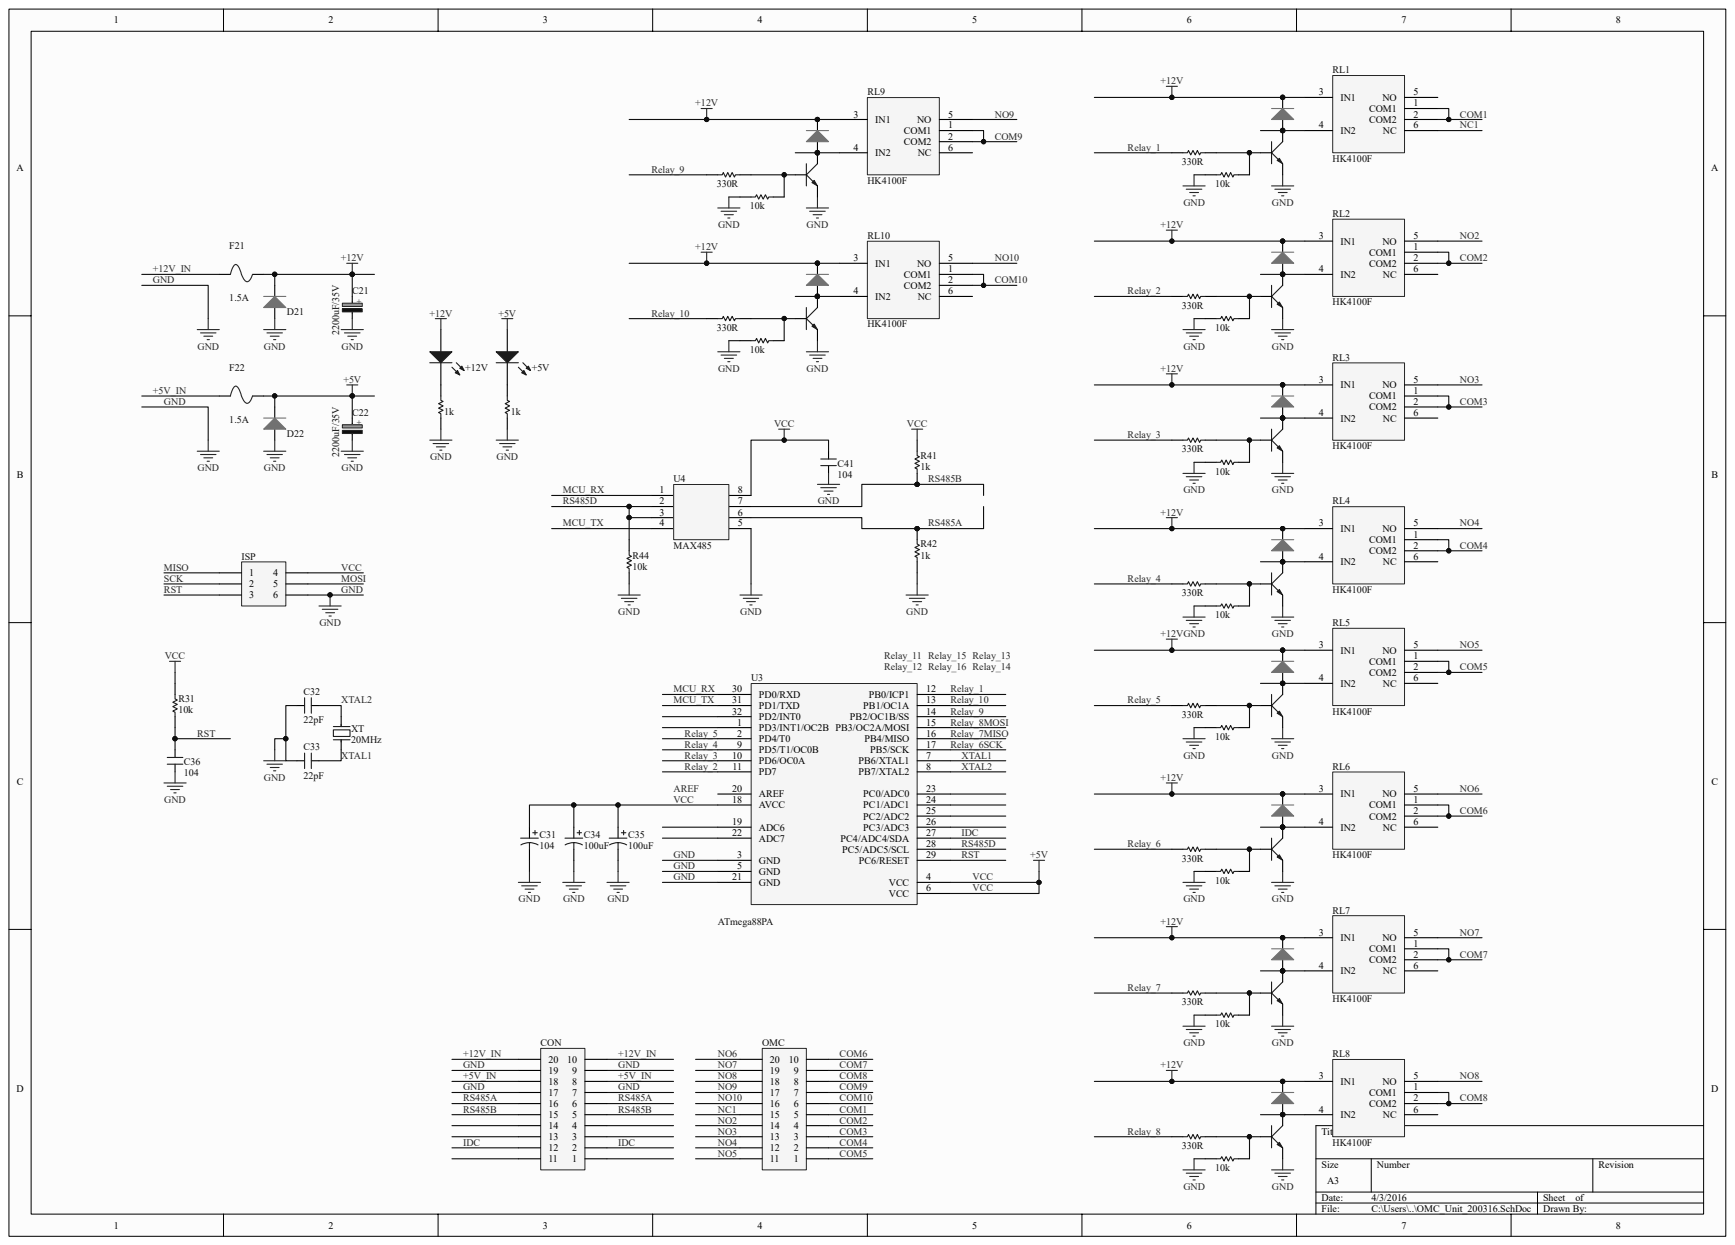
[picture p87: page 1]

Size A3 | Number | Revision

Date: 4/3/2016 | Sheet of
File: C:\Users\..\OMC_Unit_200316.SchDoc | Drawn By:
