mohammadfatemieh/BTS/Hardware/LM2596_HV/BTSM_Power_v1.pdf

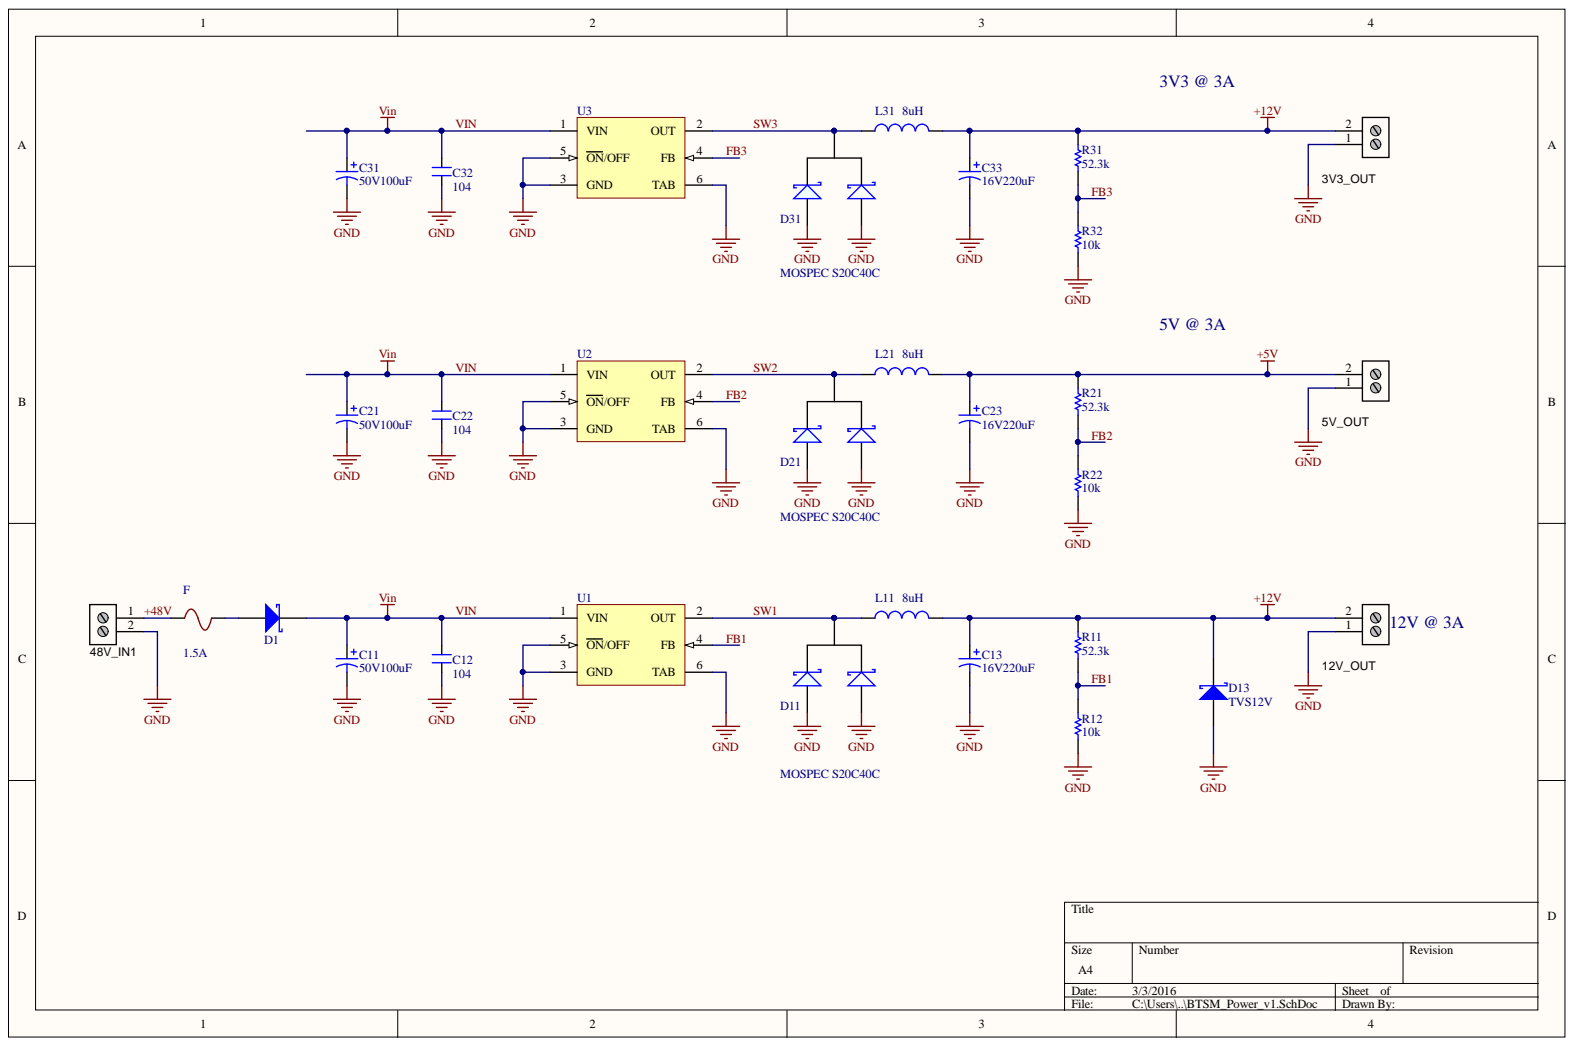
[picture p88: page 1]

Numbe r | R evision

: 3/3/2016 | She et of
File : C:\Use rs\. .\BTSM_Pow e r_v1. S chDoc | D r a wn By:
