mohammadfatemieh/BTS/Hardware/BTS HW v4/Gui Cho Phan/Mach DK Quat.pdf

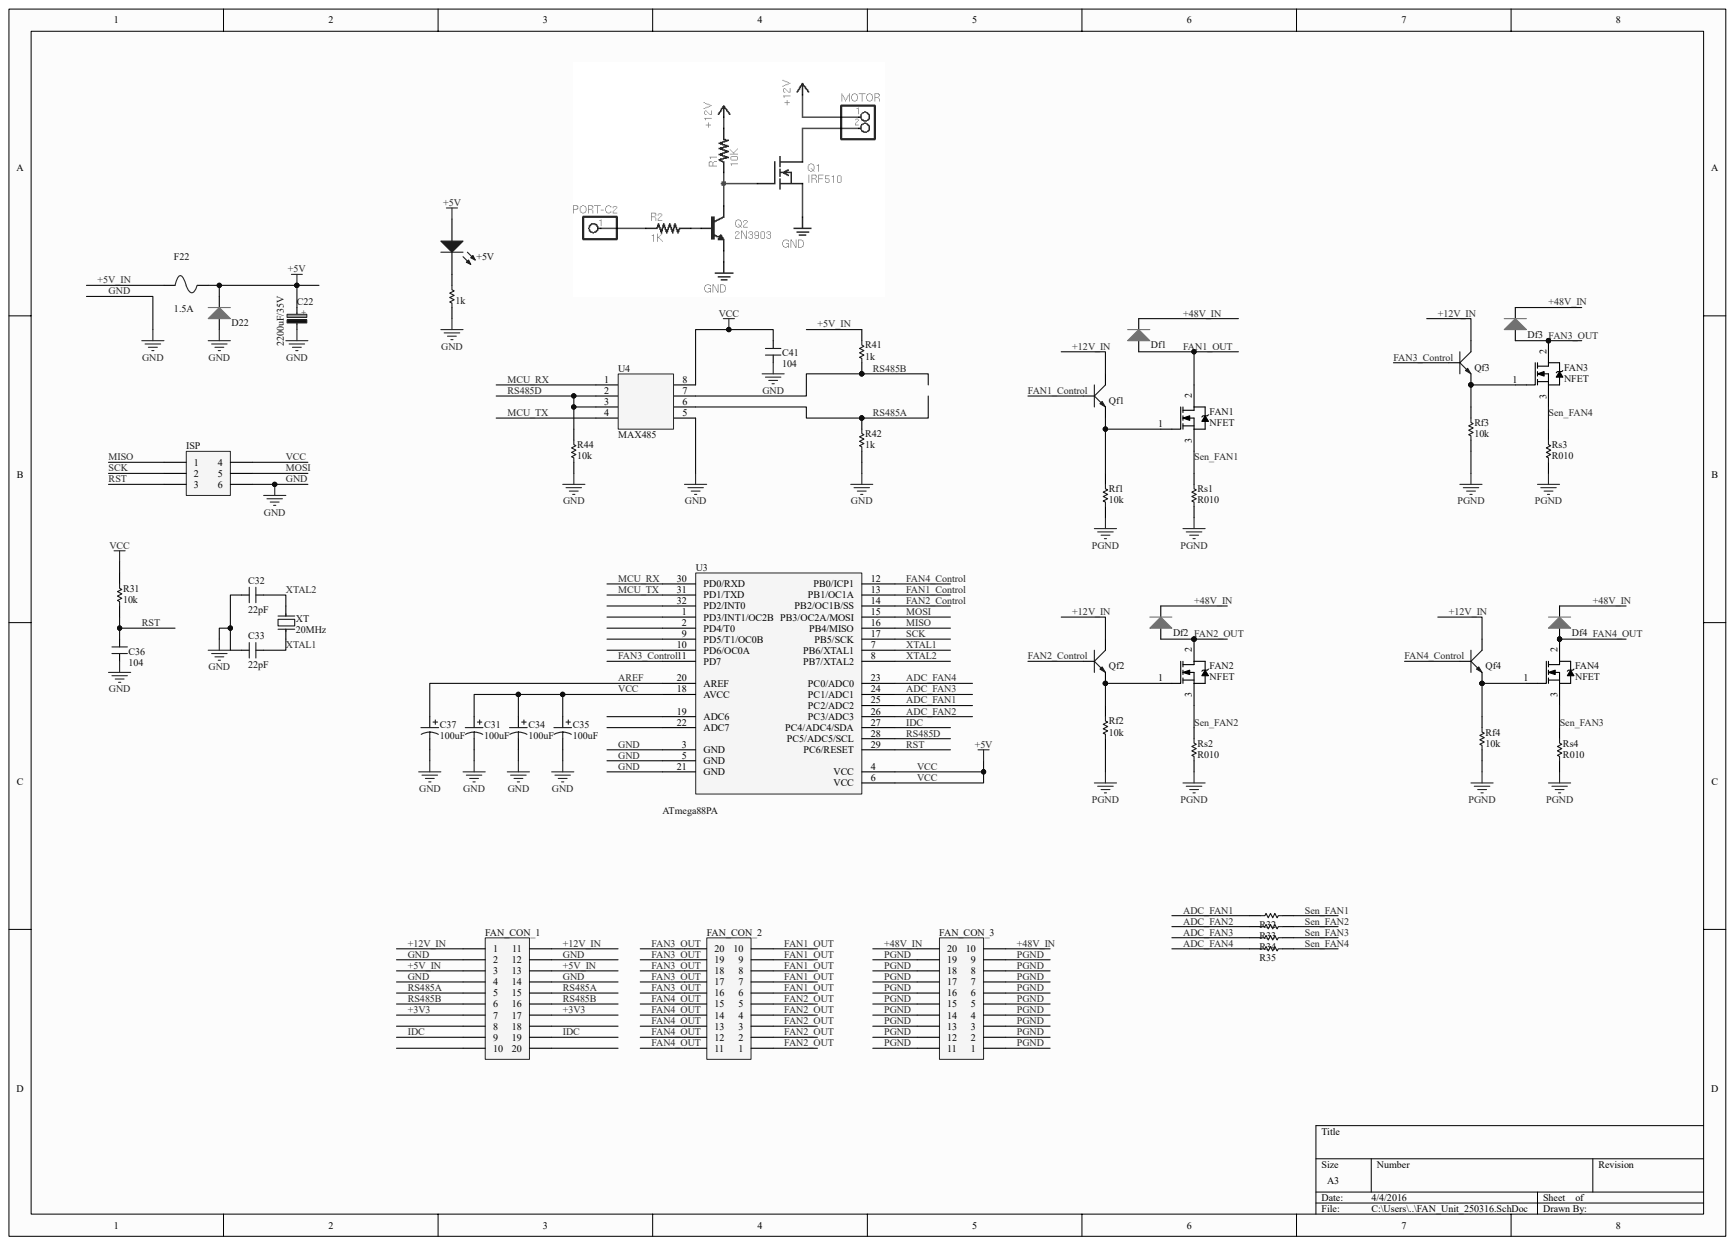
[picture p89: page 1]

Size A3 | Number | Revision

Date: 4/4/2016 | Sheet of
File: C:\Users\..\FAN_Unit_250316.SchDoc | Drawn By:
