mohammadfatemieh/BTS/Hardware/BTS HW v4/Gui Cho Phan/Mach do ADC.pdf

# ADC3 ADC4 ADC5

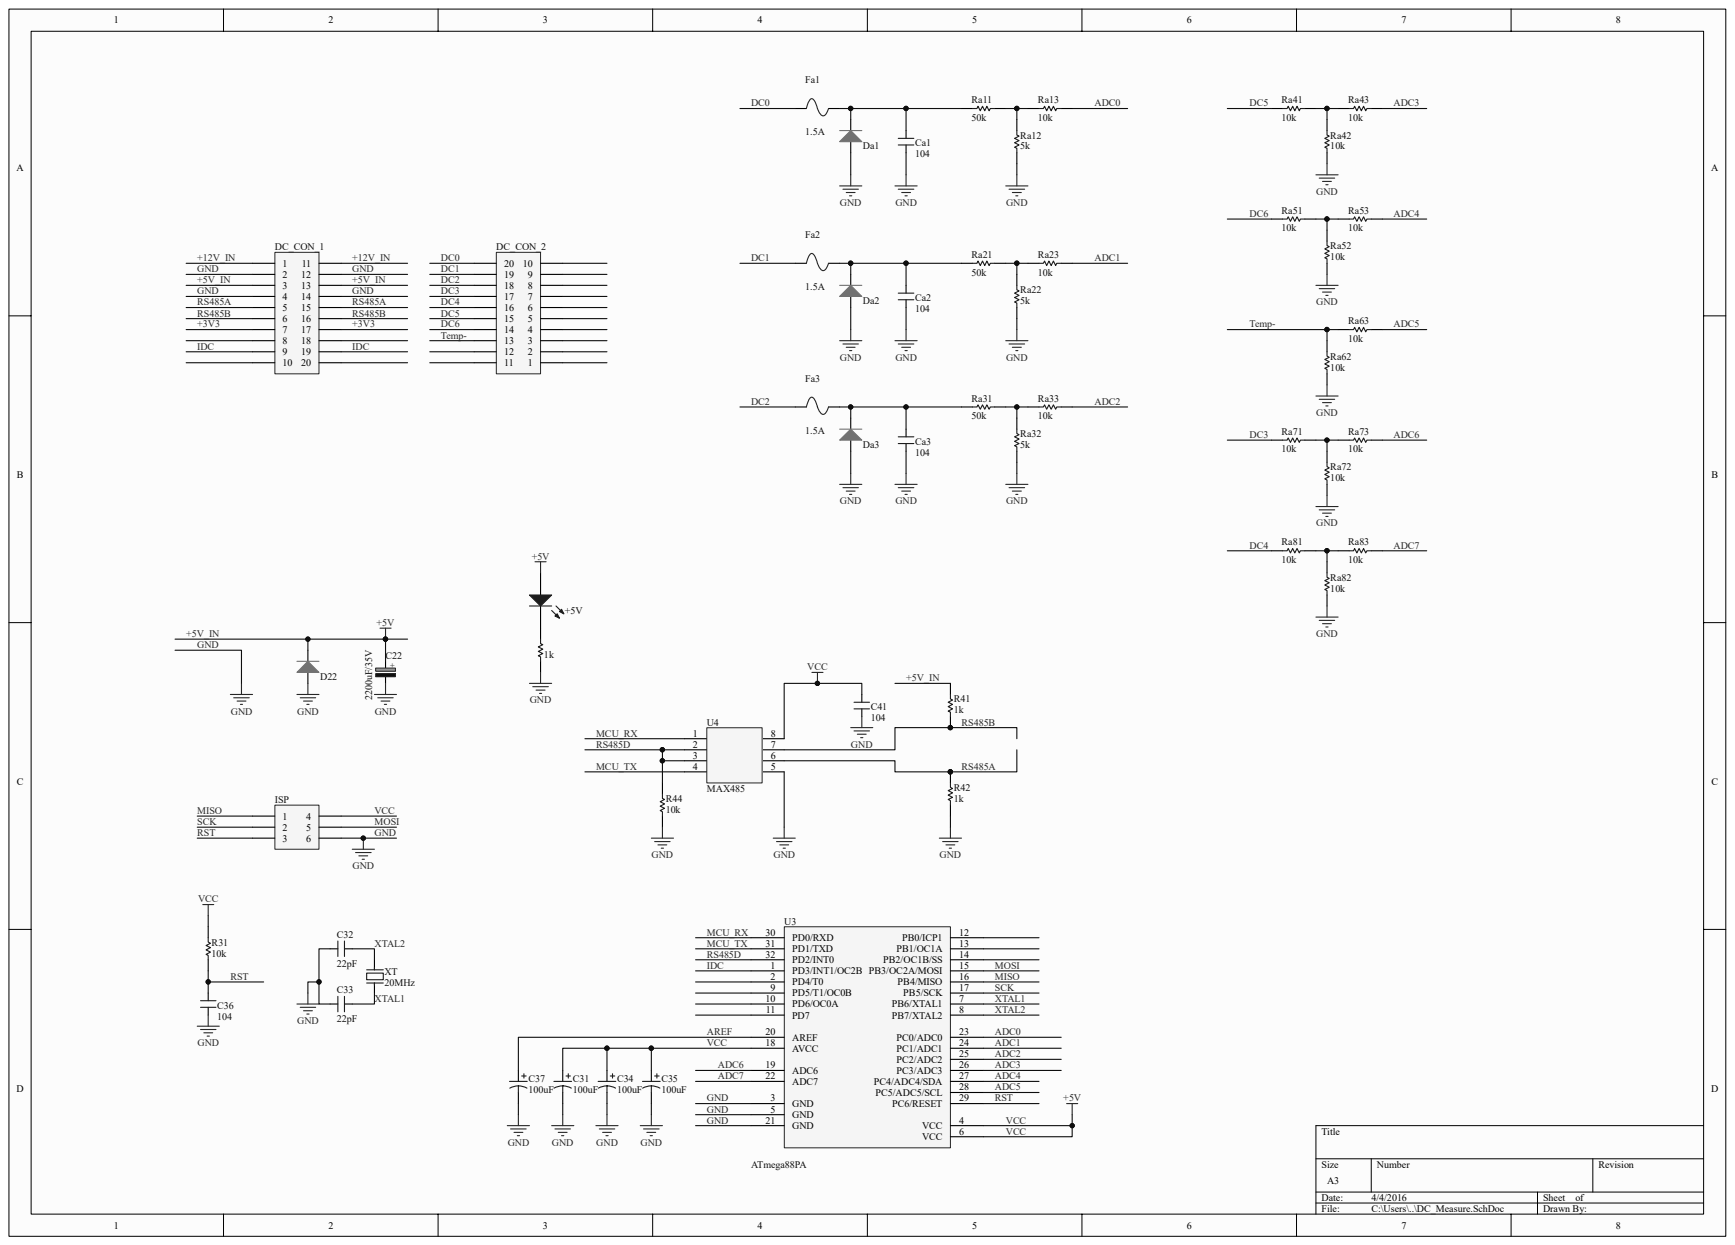
[picture p90: page 1]

Size A3 | Number | Revision

Date: 4/4/2016 | Sheet of
File: C:\Users\..\DC_Measure.SchDoc | Drawn By:
