mohammadfatemieh/BTS/Hardware/BTS HW v4/Main_Board/MainBoard04042016/MainBoard.pdf

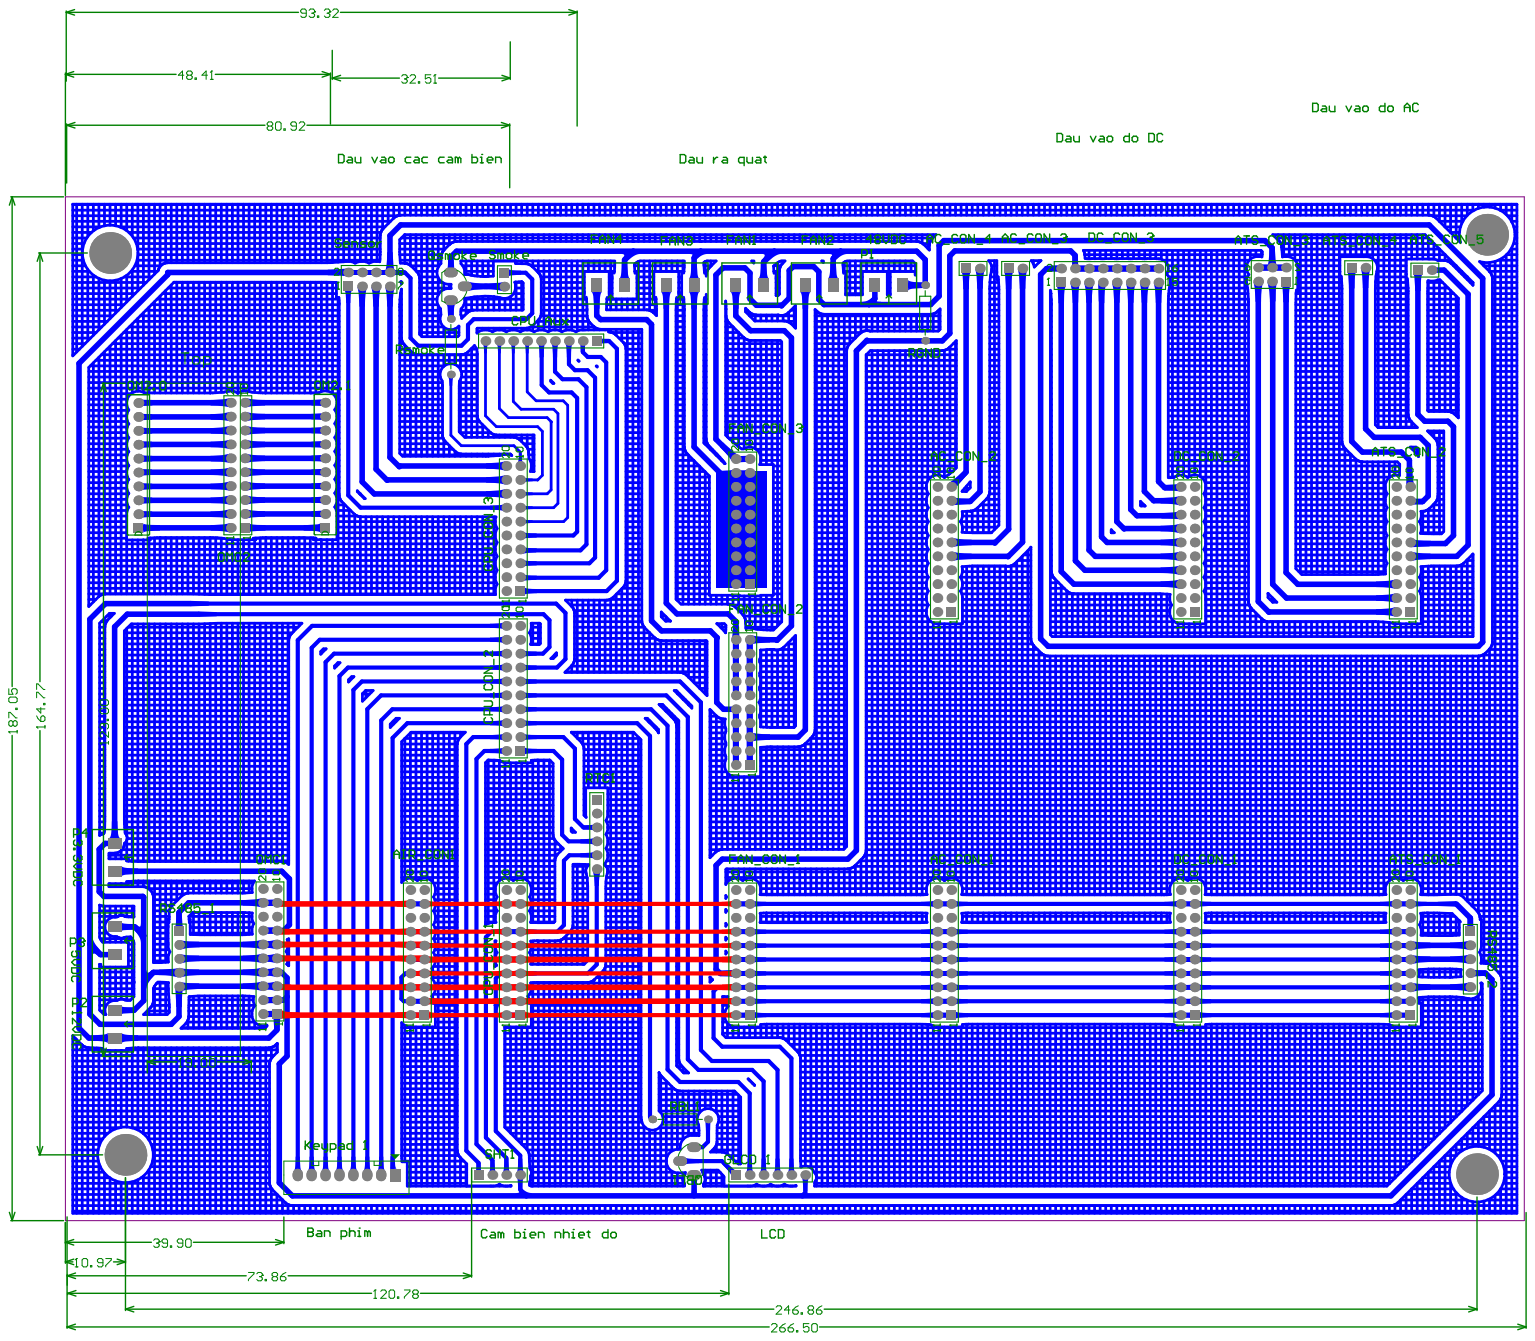
[picture p91: page 1]
