mohammadfatemieh/BTS/Composite Drawing.pdf

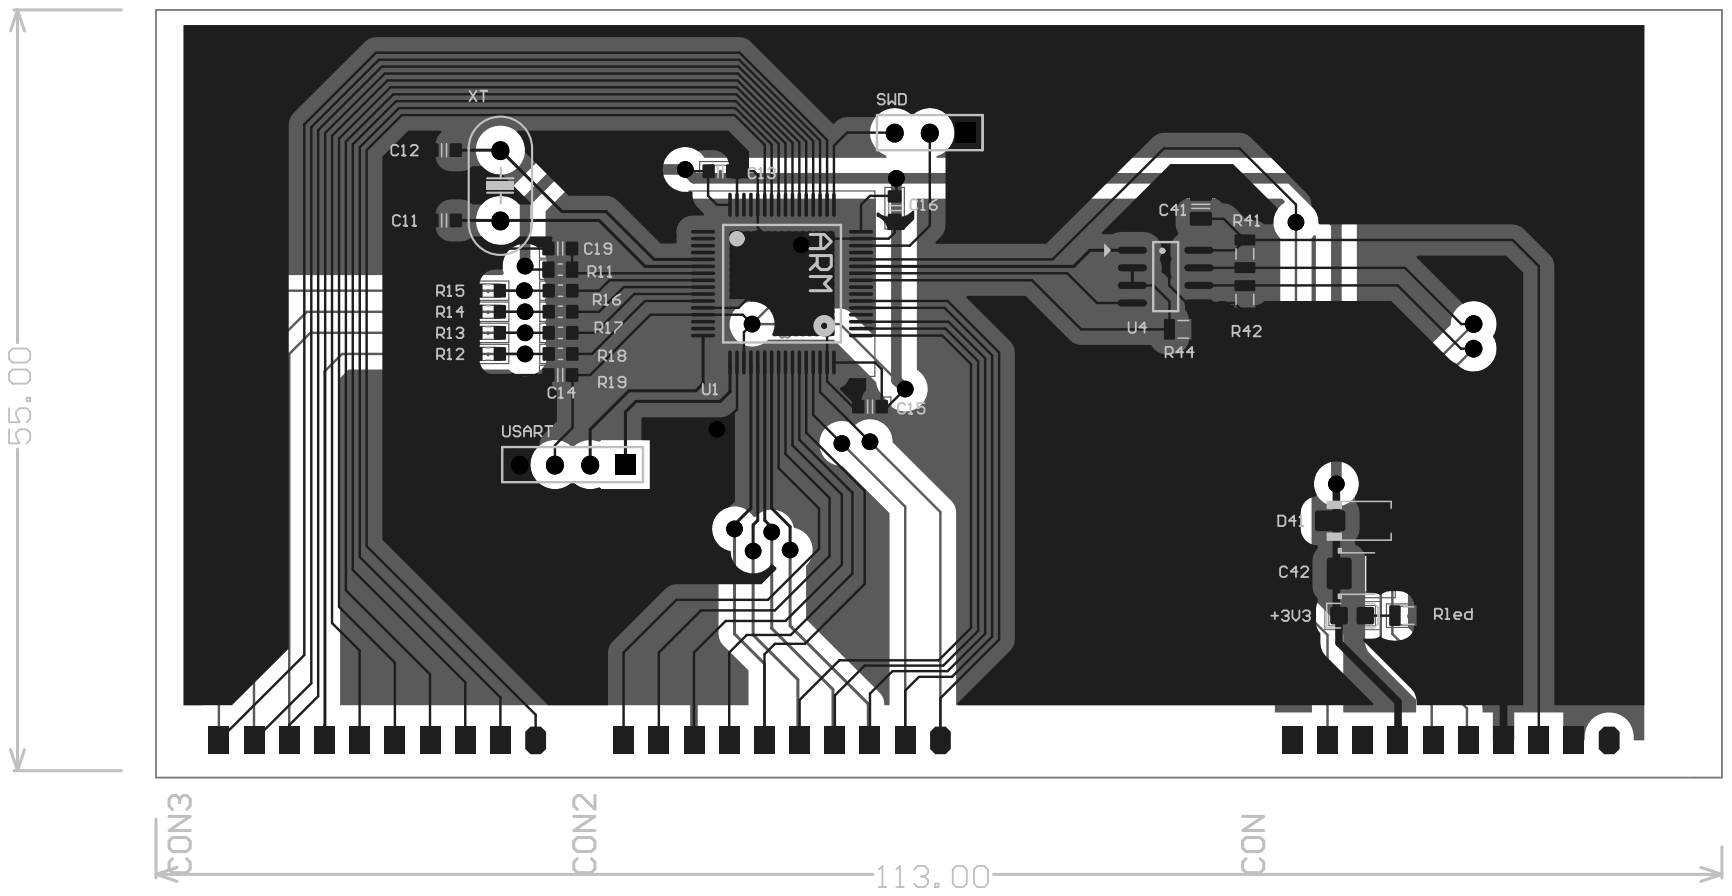
[picture p92: page 1]
