mohammadfatemieh/BTS/Doc/ETH_LAN8720_REVA.pdf

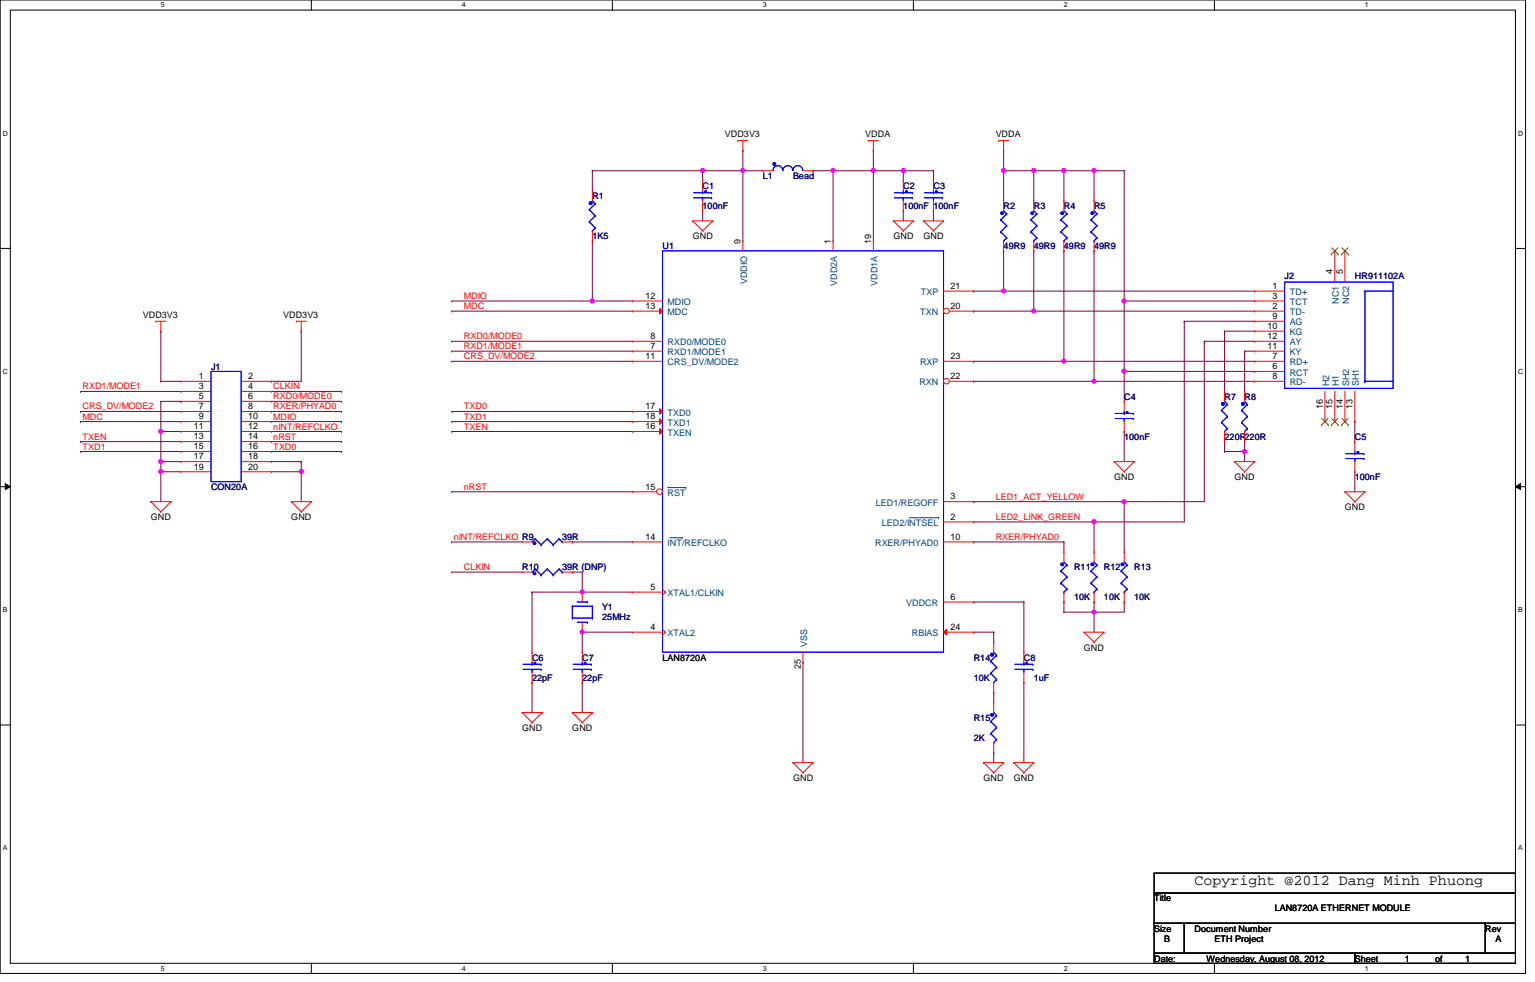
[picture p93: page 1]

Copyright @2012 Dang Minh Phuong
