mohammadfatemieh/BTS/(list of files, drawings)

Other design files:
2014.10.05_Remote_V14.3.SchDoc
Hardware/[00] Power.SchDoc
Hardware/[01] MCU.SchDoc
Hardware/[02] Amplier.SchDoc
Hardware/[03] LCD.SchDoc
Hardware/[04] Input.SchDoc
Hardware/[05] RTCvsMMC.SchDoc
Hardware/[06] Output.SchDoc
Hardware/[07] Communication.SchDoc
Hardware/AIR_Control/AIR_Control1_080116.PcbDoc
Hardware/AIR_Control/AIR_Control1_080116.PrjPcb
Hardware/AIR_Control/AIR_Control1_Main_080116.SchDoc
Hardware/AIR_Control/AIR_Control1_Relay_080116.SchDoc
Hardware/BTS HW v4/AC measure/AC2_Measure.SchDoc
Hardware/BTS HW v4/AC measure/AC_Measure.PcbDoc
Hardware/BTS HW v4/AC measure/AC_Measure.PrjPcb
Hardware/BTS HW v4/AC measure/AC_Measure.SchDoc
Hardware/BTS HW v4/AC measure/AC_Measurev2_250616.PcbDoc
Hardware/BTS HW v4/AC measure/AC_Measurev2_250616.PrjPcb
Hardware/BTS HW v4/AC measure/AC_Measurev2_250616.SchDoc
Hardware/BTS HW v4/Air_Unit/Air_Unit_240316.PcbDoc
Hardware/BTS HW v4/Air_Unit/Air_Unit_240316.PrjPcb
Hardware/BTS HW v4/Air_Unit/Air_Unit_240316.SchDoc
Hardware/BTS HW v4/ATS Unit/ATS_Unit.PcbDoc
Hardware/BTS HW v4/ATS Unit/ATS_Unit.PrjPcb
Hardware/BTS HW v4/ATS Unit/ATS_Unit.SchDoc
Hardware/BTS HW v4/CPU/CPU_22032016.PcbDoc
Hardware/BTS HW v4/CPU/CPU_22032016.PrjPcb
Hardware/BTS HW v4/CPU/CPU_22032016.SchDoc
Hardware/BTS HW v4/CPU/CPU_22032016_v2.SchDoc
Hardware/BTS HW v4/DC measure/DC_Measure.PcbDoc
Hardware/BTS HW v4/DC measure/DC_Measure.PrjPcb
Hardware/BTS HW v4/DC measure/DC_Measure.SchDoc
Hardware/BTS HW v4/FAN Unit/FAN_Unit_240316.PcbDoc
Hardware/BTS HW v4/FAN Unit/FAN_Unit_250316.PrjPcb
Hardware/BTS HW v4/FAN Unit/FAN_Unit_250316.SchDoc
Hardware/BTS HW v4/Main_Board/MainBoard04042016/MainBoard.PrjPcb
Hardware/BTS HW v4/Main_Board/MainBoard04042016/MainBoard.SchDoc
Hardware/BTS HW v4/Main_Board/MainBoard/MainBoard.PrjPcb
Hardware/BTS HW v4/Main_Board/MainBoard/MainBoard.SchDoc
Hardware/BTS HW v4/OMC Unit/OMC_Unit_200316.PcbDoc
Hardware/BTS HW v4/OMC Unit/OMC_Unit_200316.PrjPcb
Hardware/BTS HW v4/OMC Unit/OMC_Unit_200316.SchDoc
Hardware/BTS HW v4/Power_Unit/MC34063Inverting.PcbDoc
Hardware/BTS HW v4/Power_Unit/MC34063Inverting.PrjPcb
Hardware/BTS HW v4/Power_Unit/MC34063Inverting.SchDoc
Hardware/BTS HW v4/Power_Unit/PowerUnit.PcbDoc
Hardware/BTS HW v4/Power_Unit/PowerUnit.PrjPcb
Hardware/BTS HW v4/Power_Unit/PowerUnit.SchDoc
Hardware/DryContact/DryContact.PcbDoc
Hardware/DryContact/DryContact.PrjPcb
Hardware/DryContact/DryContact.SchDoc
Hardware/DryContact/SHT1x.SchDoc
Hardware/Ethernet_Board/Ethernet_boardv3_190116.PcbDoc
Hardware/Ethernet_Board/Ethernet_boardv3_09012016.PcbDoc
Hardware/Ethernet_Board/Ethernet_boardv3_09012016.PrjPcb
Hardware/Ethernet_Board/Ethernet_boardv3_09012016.SchDoc
Hardware/Ethernet_Board/STM32Ethernet.PrjPcb
Hardware/Ethernet_Board/STM32Ethernet.SchDoc
Hardware/FAN_Board/FAN_Board_Control_v1_040116.SchDoc
Hardware/FAN_Board/FAN_Boardv1_040116.PcbDoc
Hardware/FAN_Board/FAN_Boardv1_040116.PrjPcb
Hardware/FAN_Board/FAN_Boardv1_RelayAlarm_040116.SchDoc
Hardware/GLCD_Board/GLCD_Board.PcbDoc
Hardware/GLCD_Board/GLCD_Board.PrjPcb
Hardware/GLCD_Board/GLCD_Board.SchDoc
Hardware/IO_Board/IO_Board.PcbDoc
Hardware/IO_Board/IO_Board.PrjPcb
Hardware/IO_Board/IO_Board.SchDoc
Hardware/IO_Board/IO_Boardv2_301115.PcbDoc
Hardware/IO_Board/IO_Boardv2_301115.PrjPcb
Hardware/IO_Board/IO_Boardv2_301115.SchDoc
Hardware/IO_Board/IO_Boardv3_281215.PrjPcb
Hardware/IO_Board/IO_Boardv3_281215.SchDoc
Hardware/IO_Board/IO_Boardv3_RelayAlarm.SchDoc
Hardware/IOT_Masterv1/IOT_Masterv1.PcbDoc
Hardware/IOT_Masterv1/IOT_Masterv1.PrjPcb
Hardware/IOT_Masterv1/IOT_Masterv1.SchDoc
Hardware/IOT_Masterv1/IOT_Masterv2_301115.PrjPcb
Hardware/IOT_Masterv1/IOT_Masterv2_301115.SchDoc
Hardware/IOT_Masterv1/IOT_Masterv2_301115_Comunication.SchDoc
Hardware/IOT_Masterv1/IOT_Masterv2_301115_Power.SchDoc
Hardware/IOT_Masterv1/Measure_v2_301115.SchDoc
Hardware/IOT_Masterv1/Sensor.SchDoc
Hardware/IStoreMedicinv1.PrjPcb
Hardware/IStoreMedicinv1.SchDoc
Hardware/KitDemo.PrjPcb
Hardware/KitDemo.SchDoc
Hardware/KitDemo.SCHLIB
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
