mohammadfatemieh/BTS/Hardware/BTS HW v4/CPU/CPU_CODE_09042016/AM2301.c

#include "am2301.h"
#include <stdio.h>
#include <math.h>
#include "GPIO_STM32F10x.h"
#include "TA_Master_HW2_drivers.h"
#include "misc.h"
#include "stm32f10x_gpio.h"



/* Private functions */
TM_AM2301_t TM_AM2301_INT_Read(TM_AM2301_Data_t* data);
TM_AM2301_t TM_AM2301_INT_InitPins(void);


/*******************************************************************************
* Function Name  : delay_ms
* Description    : Delay Time
* Input          : - nCount: Delay Time
* Output         : None
* Return         : None
* Return         : None
* Attention		 : None
*******************************************************************************/
//static void am2301_delay_ms( uint16_t nms)    
//{ 
//	__IO uint32_t index = 0;
//	
//	/* Default system clock is 72MHz */
//	for(index = (6000 * nms); index != 0; index--);
//} 
// Notice
// Do not rename this delay_us fuction and '3' if want this lib running righ ^^. I don't know why ;)
static void delay_us(__IO uint32_t num)
{
	__IO uint32_t index = 0;
	
	/* Default system clock is 72MHz */
	for(index = (3 * num); index != 0; index--);
}

TM_AM2301_t TM_AM2301_Init(void) {
	/* Initialize delay */
	//TM_DELAY_Init();
	
	/* Initialize pin */
	//TM_GPIO_Init(AM2301_PORT, AM2301_PIN, TM_GPIO_Mode_IN, TM_GPIO_OType_PP, TM_GPIO_PuPd_UP, TM_GPIO_Speed_Medium);
	GPIO_PinConfigure(AM2301_PORT, AM2301_PIN,
										GPIO_OUT_PUSH_PULL,
										GPIO_MODE_OUT50MHZ);
	/* Pin output */
	AM2301_PIN_OUT;
	/* Set pin low for ~800-1000 us */
	AM2301_PIN_LOW;
	delay_us(1000);
	/* Set pin high to ~30 us */
	AM2301_PIN_HIGH;
	delay_us(30);
	
	/* Read mode */
	AM2301_PIN_IN;
	
	/* Return OK */
	return TM_AM2301_OK;
}

TM_AM2301_t TM_AM2301_Read(TM_AM2301_Data_t* data) {
	/* Read data */
	return TM_AM2301_INT_Read(data);
}

/* Internal function */
TM_AM2301_t TM_AM2301_INT_Read(TM_AM2301_Data_t* data) {
	uint32_t time;
	uint8_t i, j, d[5];
	
	/* Pin output */
	AM2301_PIN_OUT;
	/* Set pin low for ~800-1000 us */
	AM2301_PIN_LOW;
	delay_us(1000);
	/* Set pin high to ~30 us */
	AM2301_PIN_HIGH;
	delay_us(30);
	
	/* Read mode */
	AM2301_PIN_IN;
	
	time = 0;
	/* Wait 20us for acknowledge, low signal */
	while (AM2301_PIN_READ) {
		if (time > 20) {//luc dau la 20
			return TM_AM2301_CONNECTION_ERROR;
		}
		/* Increase time */
		time++;
		/* Wait 1 us */
		delay_us(1);
	}
	
	time = 0;
	/* Wait high signal, about 80-85us long (measured with logic analyzer) */
	while (!AM2301_PIN_READ) {
		if (time > 85) {
			return TM_AM2301_WAITHIGH_ERROR;
		}
		/* Increase time */
		time++;
		/* Wait 1 us */
		delay_us(1);
	}
	
	time = 0;
	/* Wait low signal, about 80-85us long (measured with logic analyzer) */
	while (AM2301_PIN_READ) {
		if (time > 85) {
			return TM_AM2301_WAITLOW_ERROR;
		}
		/* Increase time */
		time++;
		/* Wait 1 us */
		delay_us(1);
	}
	
	/* Read 5 bytes */
	for (j = 0; j < 5; j++) {
		d[j] = 0;
		for (i = 8; i > 0; i--) {
			/* We are in low signal now, wait for high signal and measure time */
			time = 0;
			/* Wait high signal, about 57-63us long (measured with logic analyzer) */
			while (!AM2301_PIN_READ) {
				if (time > 75) {
					return TM_AM2301_WAITHIGH_LOOP_ERROR;
				}
				/* Increase time */
				time++;
				/* Wait 1 us */
				delay_us(1);
			}
			/* High signal detected, start measure high signal, it can be 26us for 0 or 70us for 1 */
			time = 0;
			/* Wait low signal, between 26 and 70us long (measured with logic analyzer) */
			while (AM2301_PIN_READ) {
				if (time > 90) {
					return TM_AM2301_WAITLOW_LOOP_ERROR;
				}
				/* Increase time */
				time++;
				/* Wait 1 us */
				delay_us(1);
			}
			
			if (time > 18 && time < 37) {
				/* We read 0 */
			} else {
				/* We read 1 */
				d[j] |= 1 << (i - 1);
			}
		}
	}
	
	/* Check for parity */
	if (((d[0] + d[1] + d[2] + d[3]) & 0xFF) != d[4]) {
		/* Parity error, data not valid */
		return TM_AM2301_PARITY_ERROR;
	}
	
	/* Set humidity */
	data->Hum = d[0] << 8 | d[1];
	/* Negative temperature */
	if (d[2] & 0x80) {
		data->Temp = -((d[2] & 0x7F) << 8 | d[3]);
	} else {
		data->Temp = (d[2]) << 8 | d[3];
	}
	
	/* Data OK */
	return TM_AM2301_OK;
}

// example how to use it 
//TM_AM2301_Data_t data;
//		if (TM_AM2301_Read(&data) == TM_AM2301_OK) {
//                printf( "Humidity: %2.1f %%Temperature: %2.1f C\r\n", (float)data.Hum / 10, (float)data.Temp / 10);}
//	else if (TM_AM2301_Read(&data) == TM_AM2301_ERROR) printf( "TM_AM2301_ERROR");
//	else if (TM_AM2301_Read(&data) == TM_AM2301_CONNECTION_ERROR) printf( "TM_AM2301_CONNECTION_ERROR");
//	else if (TM_AM2301_Read(&data) == TM_AM2301_WAITHIGH_ERROR) printf( "TM_AM2301_WAITHIGH_ERROR");
//	else if (TM_AM2301_Read(&data) == TM_AM2301_WAITLOW_ERROR) printf( "TM_AM2301_WAITLOW_ERROR");
//	else if (TM_AM2301_Read(&data) == TM_AM2301_WAITHIGH_LOOP_ERROR) printf( "TM_AM2301_WAITHIGH_LOOP_ERROR");
//	else if (TM_AM2301_Read(&data) == TM_AM2301_WAITLOW_LOOP_ERROR) printf( "TM_AM2301_WAITLOW_LOOP_ERROR");
//	else if (TM_AM2301_Read(&data) == TM_AM2301_PARITY_ERROR) printf( "TM_AM2301_PARITY_ERROR");
